6310611030/Heatstroke-Project/Documents/CNP05-paper.pdf

ระบบแจ้งเตือนฮีทสโตรก

Heatstroke warning system
นายภัทรกร แก้วชูกุล
ภาควิชาวิศวกรรมคอมพิวเตอร์ คณะวิศวกรรมศาสตร์ มหาวิทยาลัยธรรมศาสตร์

บทคัดย่อ

ฮีทสโตรกเป็นภาวะที ่เกิดขึ้นเมื ่อร ่างกายมี อุณหภูมิที่สูงเกินไปจนกระทั่งร่างกายปรับสภาพไม่ ทัน เกิดจากการอยู ่ในสภาพอากาศที ่ร้อนจัดเป็น เวลานานซึ่งอาจท าให้เสียชีวิตได้ ในปัจจุบันเรายังไม่ มีเครื ่องมือที ่ใช้ในการแจ้งเตือนการเกิดภาวะฮีทส โตรก โครงงานนี้จึงสร้างระบบเฝ้าระวังและแจ้งเตือน ฮีทสโตรก ที่ประกอบด้วยเว็บไซต์และอุปกรณ์ IoT ที่ ประกอบด้วยไมโครคอนโทรลเลอร์ เซนเซอร์วัด อุณหภูมิแบบอินฟราเรด เซนเซอร์วัดความชื้น สัมพัทธ์และอุณหภูมิโดยรอบ เซนเซอร์วัดอัตราการ เต้นของหัวใจ และล าโพง Buzzer โดยอุปกรณ์ สามารถวัดค ่าอุณหภูมิภายใน อุณหภูมิโดยรอบ ความชื้นสัมพัทธ์ และอัตราการเต้นของหัวใจ เพื่อน า ข้อมูลดังกล ่าวไปค านวณหาค ่าความเสี่ยงที่จะเป็น ฮีทสโตรก และแจ้งเตือนผู้ใช้งาน รวมถึงเก็บข้อมูลลง ไปในฐานข้อมูลบนเว็บไซต์ เพื่อให้ผู้ที่สนใจน าข้อมูล ที ่ได้ไปวิเคราะห์และใช้งานต ่อได้จากการทดลอง พบว่าอุปกรณ์สามารถวัดค่าแล้วส่งข้อมูลไปเก็บบน เว็บไซต์ได้ และสามารถส ่งเสียงเตือนผ ่านล าโพง Buzzer ได้ ในส่วนของเว็บไซต์ก็สามารถแจ้งเตือนได้ ค าส าคัญ: ฮีทสโตรก, IoT, เซนเซอร์

Abstract

Heatstroke is a condition caused by the body's temperature being too high. It occurs when the body temperature reaches 40 degrees Celsius or more and usually occurs in the summer or in areas with high relative humidity in the air. It is considered o n e o f t h e m o s t s e r i o u s m e d i c a l emergencies. It can cause harm to vital organs such as the brain, heart, lungs, kidneys, and muscles. This is because there is no notification tool which can lead to death.

This project therefore had the idea to create a heatstroke monitoring and warning system that consists of a website using Django framework and IoT device, where the device consists of a microcontroller, infrared temperature sensor, temperature and humidity sensor, Heart Rate Sensor, and B u z z e r t o k e e p t r a c k o f t h e b o d y temperature Ambient temperature relative humidity and heart rate to use all this information to calculate the risk of heatstroke and notify users then store information in a database on the website so that those who are interested can analyze and use the information.
Keyword: Heatstroke, IoT, Sensor

บทน า

ฮีทสโตรก (Heatstroke) เป็นภาวะที ่เกิด จากร ่างกายมีอุณหภูมิที ่สูงเกินไป เกิดขึ้นเมื่อ อุณหภูมิร ่างกายสูงถึง 40 องศาเซลเซียส หรือ มากกว่า และมักจะเกิดในช่วงฤดูร้อนหรือบริเวณที่มี ความชื้นสัมพัทธ์ในอากาศสูง นับเป็นหนึ่งในภาวะ ฉุกเฉินทางการแพทย์ที่ร้ายแรง และอาจท าให้เกิด อันตรายต่ออวัยวะส าคัญ เช่น สมอง หัวใจ ปอด ไต และกล้ามเนื้อได้ เนื่องจากประเทศไทยในฤดูร้อนมี อุณหภูมิสูงในหลายภูมิภาค จากข้อมูลการเฝ้าระวัง เรื ่องการเสียชีวิตจากภาวะอากาศร้อนของกอง ระบาดวิทยา กรมควบคุมโรค ระหว ่าง มีนาคม-พฤษภาคม พ.ศ. 2558 - 2564 มีข้อมูลผู้เสียชีวิต จากภาวะอากาศร้อนจ านวนทั้งสิ้น 234 ราย ที่เกิด จากการอยู ่ในสภาพอากาศที ่ร้อนจัดเป็นเวลานาน จนกระทั ่งร ่างกายปรับสภาพไม ่ทัน การเกิด ภาวะฮีทสโตรกบุคคลทั่วไปไม่สามารถรู้ล่วงหน้าได้ เลยว่าจะเกิดภาวะฮีทสโตรกเมื่อไหร่ เนื่องจากไม่มี เครื่องมือในการแจ้งเตือนซึ่งอาจท าให้เสียชีวิตได้

โครงงานนี้จึงมีความคิดที ่สร้างระบบเฝ้า ระวังและแจ้งเตือนฮีทสโตรก เพื่อติดตามอุณหภูมิ ภายใน อุณหภูมิโดยรอบ ความชื้นสัมพัทธ์ และอัตรา การเต้นของหัวใจเพื่อน าข้อมูลดังกล่าวไปค านวณหา ค ่าความเสี ่ยงที ่จะเป็นฮีทสโตรก และแจ้งเตือน ผู้ใช้งานรวมถึงเก็บข้อมูลลงไปในฐานข้อมูลบน เว็บไซต์เพื่อให้ผู้ที่สนใจน าข้อมูลที่ได้ไปวิเคราะห์และ ใช้งานต่อได้

วัตถุประสงค์
1. เพื่อออกแบบและพัฒนาระบบตรวจจับ และเฝ้าระวังฮีทสโตรกที่สามารถแจ้งเตือน ผู้ใช้งานได้
2. เพื่อเก็บข้อมูลอุณหภูมิภายในร่างกาย อุณหภูมิโดยรอบ ค่าความชื้นสัมพัทธ์ อัตราการเต้นของหัวใจ และค านวณค่า ความเสี่ยงที่จะเกิดฮีทสโตรก
3. เพื่อรวบรวมข้อมูลส าหรับผู้สนใจน าไป วิเคราะห์หรือใช้งานต่อได้

ขอบเขตของโครงงาน
1. ออกแบบและพัฒนาระบบแจ้งเตือนที่ ประกอบไปด้วย
1.1. อุปกรณ์ตรวจวัดที่วัดค่าได้ ดังนี้ อุณหภูมิร่างกาย ความชื้นสัมพัทธ์ อุณหภูมิโดยรอบ และอัตราการเต้น ข อ ง หั ว ใ จ ป ร ะ ก อ บ ด้ ว ย ไมโครคอนโทรลเลอร์, เซนเซอร์วัด อุณหภูมิพื้นผิว, เซนเซอร์วัดความชื้น

สัม พัท ธ์แ ล ะ อุณ ห ภู มิ โ ด ย ร อ บ , เซนเซอร์วัดอัตราการเต้นของหัวใจที่ ติดไว้ที่นิ้วมือ และ Buzzer
1.2. อุปกรณ์ตรวจวัดสามารถส่งข้อมูลที่ วัดได้ไปให้ฐานข้อมูล เมื่อเซนเซอร์วัด ค่าได้ค่าสูงในระดับที่เสี่ยงต่อการเกิด ฮีทสโตรกระบบจะแจ้งเตือนผู้ใช้หาก มีโอกาสเกิดฮีทสโตรกผ่านเสียงด้วย Buzzer มี 2 ระดับดังนี้
1.1.1. ค่าความเสี่ยงสูง ใช้เสียง ความถี่สูงส่งเสียงและหยุด
เป็นระยะ
1.1.2. ค่าความเสี่ยงสูงมาก ใช้เสียง ความถี่สูงส่งเสียงต่อเนื่อง
1.2. เว็บไซต์แสดงผลระดับความเสี่ยงและ กราฟของข้อมูลที่วัดได้จากอุปกรณ์ ตรวจวัด
1.3. วิเคราะห์ ค านวณค่าความเสี่ยงใน การเกิดฮีทสโตรก แบ่งเป็นระดับ 4 ระดับ
1.3.1. ความเสี่ยงระดับปกติ
1.3.2. ความเสี่ยงระดับปานกลาง
1.3.3. ความเสี่ยงระดับสูง
1.3.4. ความเสี่ยงระดับสูงมาก
2. แสดงผลผ่านเว็บไซต์ด้วย Django framework ประกอบด้วยหน้าดังนี้
2.1. หน้า Sign up สามารถให้ผู้ที่สนใจ สมัครมาเป็นผู้ใช้งานทั่วไปได้
2.2. หน้า Login สามารถเข้าสู่ระบบและ ใช้ฟังก์ชั่น Notification ได้
2.3. หน้า Home เป็นหน้าแรกของเว็บไซต์
2.4. หน้า Display data แสดงกราฟและ สถานะความเสี่ยงที่ได้รับมาจาก อุปกรณ์
2.5. หน้า Latest data แสดงผลข้อมูล ล่าสุดที่เก็บค่าได้ถ้าผู้ใช้เข้าสู่ระบบ
2.6. หน้า Risk infoแสดงข้อมูลเกี่ยวกับ การค านวณหาค่าความเสี่ยง
3. ระบบจะรองรับผู้ใช้งาน 2 ประเภทดังนี้
3.1. ผู้ใช้งานทั่วไป สามารถดูข้อมูล ดังต่อไปนี้
3.1.1. สถานะความเสี่ยง ค่าอุณหภูมิ ภายในร่างกาย ค่าอุณหภูมิ
โดยรอบ ค่าความชื้นสัมพัทธ์ ณ ขณะนั้น
3.1.2. กราฟอุณหภูมิโดยรอบ ค่า ความชื้นสัมพัทธ์ อุณหภูมิจาก ผิวหนัง และอุณหภูมิโดยรอบ
และอุณหภูมิจากผิวหนังใน
กราฟเดียวกัน
3.1.3.อุณหภูมิโดยรอบเฉลี่ย ค่า ความชื้นสัมพัทธ์เฉลี่ย

อุณหภูมิจากผิวหนังเฉลี่ย ค่า ความเสี่ยงเฉลี่ย
3.2. ผู้ดูแ ล ะ ร ะ บ บ ส า ม า ร ถ ดูข้อ มู ล ดังต่อไปนี้
3.2.1.ข้อมูลของผู้ใช้งานแต่ละคน 3.2.2.ข้อ มูล ย้อ น ห ลัง ข อ ง แ ต่ ล ะ ผู้ใช้งาน

ประโยชนท์ คี่ าดว่าจะได้รับ
1. ได้ระบบแจ้งเตือนฮีทสโตรกที่แจ้งเตือน ผู้ใช้งานผ่านอุปกรณ์ตรวจวัดและเว็บไซต์ ที่แสดงผลเป็นระดับความเสี่ยงและกราฟ ของข้อมูลที่วัดได้จากอุปกรณ์ตรวจวัด
2. ได้กราฟที่ระบุแนวโน้มของข้อมูลที่ได้จาก อุปกรณ์ตรวจวัด ท าให้สามารถวิเคราะห์ โอกาสในการเกิดภาวะฮีทสโตรกได้ง่ายขึ้น
3. ได้ข้อมูลเกี่ยวกับฮีทสโตรก เช่น อัตราการ เต้นของหัวใจ อุณหภูมิภายในร่างกาย ความชื้นสัมพัทธ์และ อุณหภูมิโดยรอบ ซึ่ง เป็ นข้อมูลพื้นฐ านให้ผู้ที่ สนใจ น าไป วิเคราะห์และใช้งานต่อได้

ผลการด าเนินโครงงาน
1. อุปกรณ์ตรวจวัด
1.1. อุปกรณ์ตรวจวัดประกอบด้วย ESP32 DHT22 MAX30102 ติดไว้ที่นิ้วมือ

Active Buzzer และ GY-906-BAA MLX90614 วัดที่รักแร้
1.2. สามารถวัดค่าต่อไปนี้ได้ อัตราการ เต้นของหัวใจ อุณหภูมิภายนอก อุณหภูมิร่าง กา ย และ คว า ม ชื้น สัมพัทธ์และค านวณค่าความเสี่ยงที่ จะเป็นฮีทสโตรก
1.3. ส า ม า ร ถ ส่ ง ข้อ มูล ที่ วัด ไ ด้ไ ป ใ ห้ ฐานข้อมูลโดยใช้ HTTP Client
1.4. สามารถแจ้งเตือนผ่านเสียงด้วย ล าโพง Buzzer มี 2 ระดับ
1.4.1. ค่าความเสี่ยงสูง ส่งเสียงยาว และหยุดไปเรื่อย ๆ จนกว่าค่า ความเสี่ยงจะลดลง
1.4.2. ค่าความเสี่ยงสูงมาก ส่งเสียง สั้นและหยุดไปเรื่อย ๆ จนกว่า ค่าความเสี่ยงจะลดลง
1.5 ตรวจสอบความถูกต้องของการอ่าน ค่าอุณหภูมิภายนอกของ DHT22 ได้ ท าการปรับค่าจนมีเปอร์เซ็นต์ความ ค ล า ด เ ค ลื่ อ น ม า ก ที่ สุ ด ที่ 2 . 5 เปอร์เซ็นต์
1.6. ตรวจสอบความถูกต้องของการอ่าน ค่าความชื้นสัมพัทธ์ของ DHT22 ได้ ท าการปรับค่าจนมีเปอร์เซ็นต์ความ ค ล า ด เ ค ลื่ อ น ม า ก ที่ สุ ด ที่ 2 . 6 5 เปอร์เซ็นต์

1.7. ตรวจสอบความถูกต้องของการอ่าน ค่าอุณหภูมิของเซนเซอร์วัดอุณหภูมิ แบบอินฟราเรด มีข้อมูลที่มีเปอร์เซ็นต์ ความคลาดเคลื่อนมากที่สุดจะอยู่ที่ 0.55 เปอร์เซ็นต์จึงไม่ได้ท าการปรับ ค่า
1.8. ตรวจสอบความถูกต้องของการอ่าน ค่ า อัต ร า ก า ร เ ต้น ข อ ง หัว ใ จ ข อ ง เซนเซอร์วัดอัตราการเต้นของหัวใจ มี เปอร์เซ็นต์ความคลาดเคลื่อนของ เซนเซอร์สูงสุดอยู่ที่ 10.71 เปอร์เซ็นต์ แต่ค่าที่คลาดเคลื่อนไม่ไปในทิศทาง เดียวกัน ท าให้เมื่อปรับค่าแล้วยังมี เปอร์เซ็นต์ความคลาดเคลื่อนที่สูงอยู่ ซึ่งไม่อาจหลีกเลี่ยงได้จึงไม่ได้ท าการ ปรับค่า
1.9. ท าการทดลองเพื่อวัดผลว่าอุณหภูมิ ภายนอกและความชื้นสัมพัทธ์ส่งผล ต่ออุณหภูมิภายในร่างกายหรือไม่ จากการทดลองท าให้เห็นว่าอุณหภูมิ ภายนอกสูงขึ้นท าให้อุณหภูมิภายใน สูงขึ้นด้วย
2. เว็บไซต์
2.1. หน้า Home
2.2. หน้า Login
2.3. หน้า Sign up
2.4. หน้า Latest data แสดงผลข้อมูลที่ บันทึกล่าสุดที่อ่านค่าได้จากอุปกรณ์ ตรวจวัดแยกแต่ละผู้ใช้งาน โดยจะ แสดงผลก็ต่อเมื่อผู้ใช้งานเข้าสู่ระบบ
2.5. หน้า Display data มีกราฟแสดงผล พ ร้อ ม ค่ า เ ฉ ลี่ ย ข อ ง ค่ า ต่ อ ไ ป นี้ อุณหภูมิโดยรอบ ค่าความชื้นสัมพัทธ์ อุณหภูมิภายในร่างกาย ค่าความ เสี่ยงที่จะเป็ นฮีทสโตรก อุณหภูมิ โดยรอบและอุณหภูมิภายในร่างกาย ในกราฟเดียวกัน และกราฟของค่า ทั้งหมดในกราฟเดียวกัน โดยแยกแต่ ละผู้ใช้งาน โดยที่กราฟแสดงค่าความ เสี่ยงที่จะเป็นฮีทสโตรกจะแบ่งแถบสี ตามความเสี่ยง
2.6. การแจ้งเตือนบนเว็บไซต์เมื่อข้อมูลที่ ได้รับจากอุปกรณ์ตรวจวัดมีค่าความ เสี่ยงที่จะเป็นฮีทสโตรกสูงหรือสูงมาก เว็บไซต์จะท าการแจ้งเตือน โดยจะมี การแจ้งเตือน 2 แบบด้วยกันคือแบบ JavaScript alert และแบบ local notification

สรุปและข้อเสนอแนะ
1. สรุปผลโครงงาน
โครงงานนี้ได้พัฒนาระบบแจ้งเตือน ฮีทสโตรกที่วัดค่าจากอุปกรณ์ตรวจวัดที่

ประกอบไปด้วย Esp32 DHT22 Max30102 A c t i v e b u z z e r แ ล ะ GY -906- B A A MLX90614 แล้วน าค่าที่วัดได้ ไปค านวณ เป็นค่าความเสี่ยงที่จะเป็นฮีทสโตรก และแจ้ง เตือน ผ่าน buzzer เมื่อมีค่าความเสี่ยงที่จะ เป็นheat Stroke สูง จากนั้นน าข้อมูลที่ได้ไป บันทึกลงฐานข้อมูลและแสดงบนเว็บไซต์ พร้อมแจ้งเตือนเมื่อมีค่าความเสี่ยงที่จะเป็น ฮีทสโตรกสูง โดยที่เว็บไซต์แสดงข้อมูลเป็น กราฟของอุณหภูมิภายในร่างกาย อุณหภูมิ ภายนอก ความชื้นสัมพัทธ์ ค่าความเสี่ยงที่ เป็นฮีทสโตรก และอัตราการเต้นของหัวใจ
2. ข้อเสนอแนะ
2.1. พัฒนาเป็นเว็บแอปพลิเคชันเพื่อเข้าถึง ผู้ใช้งานได้ง่ายและสะดวกขึ้น
2.2. ขอความเห็นจากแพทย์เพื่อให้สามารถ พัฒนาระบบแจ้งเตือนได้แม่นย ามากขึ้น

บรรณานุกรม
[1] D. Ruthirago and P. Laengvejkal, “Be careful of heatstroke – a potentially life-
threatening form of heat illness | Bangkok
International Hospital,”
www.bangkokinternationalhospital.com. https://www.bangkokinternationalhospital.com/health-articles/disease-treatment/hot-weather-must-be-careful-of-heatstroke (accessed Nov. 13, 2023).
[2] Mouser Electronics, “MLX90614 family,” Mouser Electronics.
https://th.mouser.com/ProductDetail/Melexis/MLX90614ESF-BAA-000-
TU?qs=KuGPmAKtFKVScNDmoJmFVw%3D %3D&_gl=1*41x8p3*_ga*MTg2NTM4MTQ3Ni 4xNzE2MjI2Mzk4*_ga_15W4STQT4T*MTcxNjI yNjM5Ny4xLjAuMTcxNjIyNjQwMi41NS4wLjA.
[3] Texas Instruments, “LM35 data sheet,
product information and support | TI.com,”
Ti.com, 2017.
https://www.ti.com/product/LM35
[4] Bosch Sensortec GmbH, “BME280 sensor API,” GitHub, Nov. 03, 2023. https://github.com/BoschSensortec/BME280_driver (accessed Nov. 20, 2023).
[5] Adafruit Industries, “DHT22 temperature-humidity sensor + extras,” Adafruit.com, 2019. https://www.adafruit.com/product/385
[6] Sensirion AG, “SHT35-DIS-F,” sensirion.com.
https://sensirion.com/products/catalog/SHT35 -DIS-F (accessed Nov. 20, 2023).

[7] Texas Instruments Incorporated, “HDC1080 data sheet, product information
and support | TI.com,” www.ti.com.
https://www.ti.com/product/HDC1080 (accessed Nov. 20, 2023).
[8] Espressif, “ESP32 Series Datasheet .” Available:
https://www.espressif.com/sites/default/files/documentation/esp32_datasheet_en.pdf
[9] World Famous Electronics LLC, “WorldFamousElectronics/PulseSensorPlaygr ound,” GitHub, May 19, 2023. https://github.com/WorldFamousElectronics/P ulseSensorPlayground
[10] Analog Devices, “MAX30102 High-Sensitivity Pulse Oximeter and Heart-Rate
Sensor for Wearable Health | Analog
Devices,” Analog.com, 2018. https://www.analog.com/en/products/max301 02.html
[11] Django, “Django,” Django Project. https://docs.djangoproject.com/en/4.2/
[12] S.-T. Chen, S.-S. Lin, C.-W. Lan, and H.-
Y. Hsu, “Design and Development of a Wearable Device for Heat Stroke Detection,”

Sensors, vol. 18, no. 2, p. 17, Dec. 2017, doi: https://doi.org/10.3390/s18010017.
[13] T. W. Son, D. A. Ramli, and A. A. Aziz, “Wearable Heat Stroke Detection System in IoT-based Environment,” Procedia Computer Science, vol. 192, pp. 3686–3695, 2021, doi: https://doi.org/10.1016/j.procs.2021.09.142.
[14] M. I. R. and D. THAI METEOROLOGICAL DEPARTMENT, “Heat Index R&D TMD,” www.rnd.tmd.go.th.
http://www.rnd.tmd.go.th/heatindexanalysis/ .
[15] S.-S. Lin, C.-W. Lan, H.-Y. Hsu, and S.-T. Chen, “Data Analytics of a Wearable Device for Heat Stroke Detection,” Sensors, vol. 18, no. 12, p. 4347, Dec. 2018, doi: https://doi.org/10.3390/s18124347.
[16] SYNPHAET HOSPITAL, “โรคฮีทสโตรก (Heat Stroke) หรือโรคลมแดด - โรงพยาบาลสิน แพทย์,” โรงพยาบาลสินแพทย์, Mar. 28, 2023. https://www.synphaet.co.th/%E0%B9%82%E 0%B8%A3%E0%B8%84%E0%B8%AE%E0% B8%B5%E0%B8%97%E0%B8%AA%E0%B9 %82%E0%B8%95%E0%B8%A3%E0%B8%8 1-heat-stroke-
%E0%B8%AB%E0%B8%A3%E0%B8%B7%E

0%B8%AD%E0%B9%82%E0%B8%A3%E0% B8%84%E0%B8%A5%E0%B8%A1/
[17] ส านักงานป้องกันควบคุมโรคที่ 7ขอนแก่น, “แพทย์เตือน ภาวะเจ็บป่ วยจากลมร้อน ‘ฮีทสโตรก’ เสี่ยงอาการรุนแรง และอาจเสียชีวิตได้,” ddc.moph.go.th, Mar. 25, 2022. https://ddc.moph.go.th/odpc7/news.php?news=24196&deptcode=odpc7&news_views=42 72
[18] Centers for Disease Control and Prevention, “Frequently Asked Questions
(FAQ) About Extreme Heat | Natural Disasters
and Severe Weather | CDC,” www.cdc.gov,
Apr. 14, 2020.
https://www.cdc.gov/disasters/extremeheat/faq.html#:~:text=Heat%20stroke%20is%20the %20most
[19] T. Durongbhandhu, “โรคลมร้อน (Heat Stroke) ,” Thailand Digital Journal, Oct. 2019. https://thaidj.org/index.php/CHJ/article/download/7412/7641/11666
[20] Adafruit, “adafruit/DHT-sensor-library,” GitHub, May 04, 2020.
https://github.com/adafruit/DHT-sensor-library
[21] โรงพยาบาลศิครินทร์, “วิธีเช็ดตัว ‘ลดไข้’ ที่ ถูกต้อง ควรท าอย่างไร ? - โรงพยาบาลศิครินทร์,” โรงพยาบาลศิครินทร์, Aug. 19, 2021. https://www.sikarin.com/health/%e0%b8%a7 %e0%b8%b4%e0%b8%98%e0%b8%b5%e0 %b9%80%e0%b8%8a%e0%b9%87%e0%b8 %94%e0%b8%95%e0%b8%b1%e0%b8%a7-%e0%b8%a5%e0%b8%94%e0%b9%84%e0 %b8%82%e0%b9%89-
%e0%b8%97%e0%b8%b5%e0%b9%88%e0 %b8%96%e0%b8%b9 (accessed Feb. 5, 2024).
