6310611030/Heatstroke-Project/Documents/CNP05-progress2.pdf

### รายงานความคืบหน้าโครงงาน 2

ชื่อโครงงานภาษาไทย: ระบบแจ้งเตือนฮีทสโตรก

ชื่อโครงงานภาษาอังกฤษ: Heatstroke warning system

ชื่อและเลขทะเบียนนักศึกษา: ภัทรกร แก้วชูกุล 6310611030

อาจารย์ที่ปรึกษา: อ.ดร.กาญจนา ศิลาวราเวทย์

### 1. เค้าโครงของโครงงาน 1.1. ที่มาและความส าคัญ

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

### 1.2. วัตถุประสงค์

### 1.2.1. เพื่อออกแบบและพัฒนาระบบตรวจจับและเฝ้าระวังฮีทสโตรกที่สามารถแจ้งเตือนผู้ใช้งานได้

1.2.2. เพื่อเก็บข้อมูลอุณหภูมิภายในร่างกาย อุณหภูมิโดยรอบ ค่าความชื้นสัมพัทธ์อัตราการเต้นของ หัวใจ และค านวณค่าความเสี่ยงที่จะเกิดฮีทสโตรก

### 1.2.3. เพื่อรวบรวมข้อมูลส าหรับผู้สนใจน าไปวิเคราะห์หรือใช้งานต่อได้

### 1.3. ขอบเขต

### 1.3.1 ออกแบบและพัฒนาระบบแจ้งเตือนที่ประกอบไปด้วย

- อุปกรณ์ตรวจวัดที่วัดค่าได้ ดังนี้ อุณหภูมิร่างกาย ความชื้นสัมพัทธ์อุณหภูมิโดยรอบ และ อัตราการเต้นของหัวใจ ประกอบด้วยไมโครคอนโทรลเลอร์, เซนเซอร์วัดอุณหภูมิพื้นผิว, เซนเซอร์วัดความชื้นสัมพัทธ์และอุณหภูมิโดยรอบ, เซนเซอร์วัดอัตราการเต้นของหัวใจที่ติดไว้ที่ นิ้วมือ และ Buzzer
- อุปกรณ์ตรวจวัดสามารถส่งข้อมูลที่วัดได้ไปให้ฐานข้อมูล เมื่อเซนเซอร์วัดค่าได้ค่าสูงในระดับที่ เสี ่ยงต ่อการเกิดฮีทสโตรกระบบจะแจ้งเตือนผู้ใช้หากมีโอกาสเกิดฮีทสโตรกผ่านเสียงด้วย Buzzer มี 2 ระดับดังนี้
- ค่าความเสี่ยงสูง ใช้เสียงความถี่สูงส่งเสียงและหยุดเป็นระยะ
- ค่าความเสี่ยงสูงมาก ใช้เสียงความถี่สูงส่งเสียงต่อเนื่อง
- เว็บไซต์แสดงผลระดับความเสี่ยงและกราฟของข้อมูลที่วัดได้จากอุปกรณ์ตรวจวัด
- วิเคราะห์ ค านวณค่าความเสี่ยงในการเกิดฮีทสโตรก แบ่งเป็นระดับ 4 ระดับ
- ความเสี่ยงระดับปกติ
- ความเสี่ยงระดับปานกลาง
- ความเสี่ยงระดับสูง
- ความเสี่ยงระดับสูงมาก

### 1.3.2 แสดงผลผ่านเว็บไซต์ด้วย Django framework ประกอบด้วยหน้าดังนี้

- หน้า Sign up สามารถให้ผู้ที่สนใจสมัครมาเป็นผู้ใช้งานทั่วไปได้
- หน้า Login สามารถเข้าสู่ระบบและใช้ฟังก์ชั่น Notification ได้
- หน้า Home เป็นหน้าแรกของเว็บไซต์
- หน้า Display data แสดงกราฟและสถานะความเสี่ยงที่ได้รับมาจากอุปกรณ์
- หน้า Latest data แสดงผลข้อมูลล่าสุดที่เก็บค่าได้ถ้าผู้ใช้เข้าสู่ระบบ

### 1.3.3 ระบบจะรองรับผู้ใช้งาน 2 ประเภทดังนี้

- ผู้ใช้งานทั่วไป สามารถดูข้อมูลดังต่อไปนี้
- สถานะความเสี่ยง
- ค่าอุณหภูมิภายในร่างกาย ค่าอุณหภูมิโดยรอบ ค่าความชื้นสัมพัทธ์ณ ขณะนั้น
- กราฟอุณหภูมิโดยรอบ ค่าความชื้นสัมพัทธ์อุณหภูมิจากผิวหนัง อุณหภูมิโดยรอบ เฉลี่ย ค่าความชื้นสัมพัทธ์เฉลี่ย อุณหภูมิจากผิวหนังเฉลี่ย และอุณหภูมิโดยรอบและ อุณหภูมิจากผิวหนังในกราฟเดียวกัน

- ผู้ดูและระบบ สามารถดูข้อมูลดังต่อไปนี้
- เลือกข้อมูลของผู้ใช้งานแต่ละคน
- กราฟแสดงผลภาพรวมรายวันจากทุกผู้ใช้งานโดยรวม กราฟอุณหภูมิโดยรอบ ค่าความชื้น สัมพัทธ์อุณหภูมิจากผิวหนัง อุณหภูมิโดยรอบเฉลี่ย ค่าความชื้นสัมพัทธ์เฉลี่ย อุณหภูมิ จากผิวหนังเฉลี่ย และอุณหภูมิโดยรอบและอุณหภูมิจากผิวหนังในกราฟเดียวกัน
- สถานะความเสี่ยงย้อนหลังของแต่ละผู้ใช้งาน

### 1.4. ประโยชน์ที่คาดว่าจะได้รับ

1.4.1 ได้ระบบแจ้งเตือนฮีทสโตรกที่แจ้งเตือนผู้ใช้งานผ่านอุปกรณ์ตรวจวัดและเว็บไซต์ที่แสดงผลเป็น ระดับความเสี่ยงและกราฟของข้อมูลที่วัดได้จากอุปกรณ์ตรวจวัด
1.4.2 ได้ข้อมูลเกี่ยวกับฮีทสโตรกที่เป็นข้อมูลพื้นฐานให้ผู้ที่สนใจน าไปวิเคราะห์และใช้งานต่อได้

### 2. สรุปผลการด าเนินการโครงงาน 1 2.1. อุปกรณ์ตรวจวัด 2.1.1. วัดค่าอุณหภูมิโดยรอบ อุณหภูมิจากผิวหนังและค่าความชื้นสัมพัทธ์ 2.1.2. ส่งข้อมูลที่วัดได้ไปยังฐานข้อมูล 2.1.3. ส่งเสียงแจ้งเตือนเมื่ออุปกรณ์วัดค่าได้ถึงค่าที่ก าหนด

### 2.2. เว็บไซต์ 2.2.1. รับข้อมูลจากอุปกรณ์มาเก็บเข้าฐานข้อมูล 2.2.2. สร้างผู้ใช้งานใหม่ในระบบ 2.2.3. เข้าสู่ระบบ

### 2.2.4. ออกจากระบบ 3. ผลการด าเนินการโครงงาน 2 3.1. การทดลอง

3.1.1.ตรวจสอบความถูกต้องของการอ่านค่าอุณหภูมิของ DHT22 โดยการเปรียบเทียบอุณหภูมิกับเทอร์โมมิเตอร์แบบปรอท (เนื่องจากเทอร์โมมิเตอร์ที่น ามาใช้ในการ วัดไม่สามารถวัดจุดทศนิยมได้จึงอาจท าให้เกิดการคลาดเคลื่อน) เริ่มการตั้งค่าโดยน า DHT22 และ เทอร์โมมิเตอร์มาไว้ที่จุดเดียวกัน รอจนอุณหภูมิคงที่และท าการวัดค่าที่ได้ ท าการวัดทุกๆ ครึ่งชั่วโมง เป็นเวลา 6 ชั่วโมง ถ้าค่าที่ได้จากเซนเซอร์DHT22 มีความคลาดเคลื่อนมากกว่า 5 เปอร์เซ็นต์จึงจะ ท าการปรับให้ใกล้เคียง

ตารางที่ 1 แสดงค่าอุณหภูมิที่ที่วัดได้จากเทอร์โมมิเตอร์และเซนเซอร์ พร้อมทั้งเปอร์เซ็นต์ความคลาดเคลื่อนของเซนเซอร์
ล ำดับที่ | อุณหภูมิจำก เทอร์โมมิเตอร์ (°C) | อุณหภูมิจำกเซนเซอร์ (°C) | เปอร์เซ็นต์ควำมคลำด เคลื่อน (%)
1 | 26 | 25.1 | 3.46
2 | 24 | 24.4 | 1.67
3 | 25 | 24.4 | 2.40
4 | 24 | 25.2 | 5.00
5 | 25 | 24.8 | 0.80
6 | 25 | 25.0 | 0
7 | 29 | 29.0 | 0
8 | 30 | 30.5 | 1.67
9 | 31 | 30.9 | 0.32
10 | 26 | 25.6 | 1.54
11 | 25 | 24.2 | 3.20
12 | 24 | 23.7 | 1.25
จากตารางที่ 1 เริ่มการตรวจสอบโดยวัดอุณหภูมิขณะที่อยู่ในห้องแอร์ข้อมูลล าดับที่ 1 – 6 และ 10 – 12 เป็นการวัดขณะเปิดแอร์ และข้อมูลล าดับที่ 7 – 9 เป็นการวัดขณะปิดแอร์ค ่าความ คลาดเคลื่อนมีความไม่แน่นอนเนื่องจากเทอร์โมมิเตอร์ที่ใช้เป็นแบบ analog ไม่มีจุดทศนิยม จากการ

Fig.1: กราฟเปรียบเทียบค่าอุณหภูมิที่ที่วัดได้จากเทอร์โมมิเตอร์และเซนเซอร์

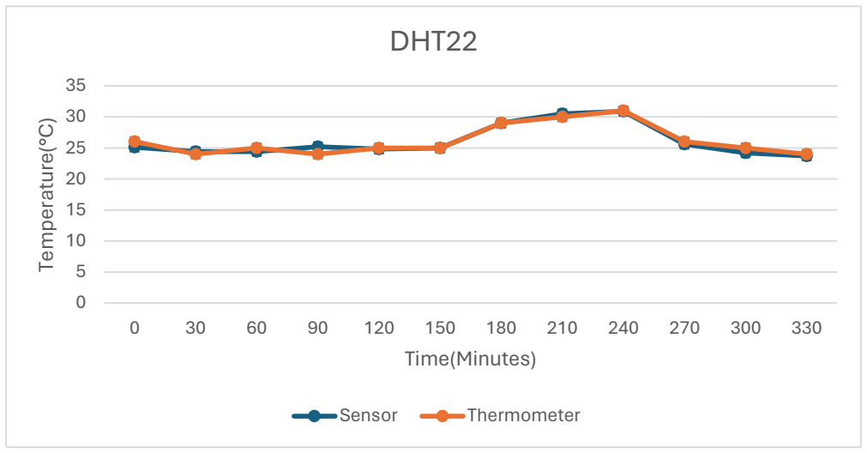
[picture p3: figure]
Temperature(°C); Time(Minutes); DHT22; Sensor; Thermometer

จากกราฟจะเห็นได้ว่าค่าของเซนเซอร์และเทอร์โมมิเตอร์มีความใกล้เคียงและมีแนวโน้มไปในทิศทาง เดียวกัน จากการวัดพบว่าเกิดความคลาดเคลื่อนมากกว่า 5 เปอร์เซ็นต์จึงท าการตั่งค่าชดเชยเพื่อให้ ได้ค่าที่ใกล้เคียงค่าที่ถูกต้องและมีความคลาดเคลื่อนไม่เกิน 5 เปอร์เซ็นต์

### 3.1.2. ตรวจสอบความถูกต้องของการอ่านค่าอุณหภูมิของเซนเซอร์วัดอุณหภูมิแบบอินฟราเรด

โดยการเปรียบเทียบอุณหภูมิที่วัดได้กับเทอร์โมมิเตอร์วัดไข้ เริ่มการตั้งค่าโดยการน าเทอร์โมมิเตอร์วัด ไข้มาเสียบไว้ที่รักแร้และน าเซนเซอร์มาวัดที่ข้อมือโดยมีระยะห่าง 4 เซนติเมตร รอจนเทอร์โมมิเตอร์ วัดไข้วัดแล้วอุณหภูมิไม่เปลี่ยนแปลงแล้วน าค่าที่ได้มาเปรียบเทียบกับค่าที่วัดได้จากเซนเซอร์ในเวลา เดียวกัน ท าการวัดทุกๆ ครึ่งชั่วโมงเป็นเวลา 6 ชั่วโมง 3.1.3.ตรวจสอบความถูกต้องของการอ่านค่าอัตราการเต้นของหัวใจของเซนเซอร์วัดอัตราการ เต้นของหัวใจ
โดยการเปรียบเทียบกับเครื่องวัดความดัน(Omron)และนาฬิกาสุขภาพ(Garmin) เริ่มการตั้งค่าโดย น าปลอกแขนของเครื่องวัดความดันใส่ไว้ที่แขนข้างใดข้างหนึ่งและน านาฬิกากับเซนเซอร์มาใส่ไว้ที่ แขนข้างเดียวกัน(เซนเซอร์สวมไว้ที่นิ้วโป้งรัดด้วยหนังยางหรือตีนตุ๊กแก) จากนั้นท าการวัดค่าด้วย เครื่องวัดความดัน เมื่อวัดเสร็จน าค่าที่ได้ไปเปรียบเทียบกับค่าที่วัดได้ของเซนเซอร์และนาฬิกาในเวลา เดียวกัน ท าการวัดทุกๆ ครึ่งชั่วโมงเป็นเวลา 6 ชั่วโมง

### 3.1.4. ท าการทดลองเพื่อวัดผลว่าอุณหภูมิภายนอกและความชื้นสัมพัทธ์ส่งผลต่ออุณหภูมิ

ภายในร่างกายหรือไม่
โดยใช้เซนเซอร์ DHT 22 และเซนเซอร์วัดอุณหภูมิแบบอินฟราเรด เริ่มการทดลองโดยการนั่งรอจน อุณหภูมิร่างกายคงที่ จากนั้นจึงท าการวัดค่าและบันทึกผลทุกๆ 30 วินาที

### 3.2. เว็บไซต์

3.2.1.หน้า Home
มีการเพิ่มลิงค์เพื่อเข้าสู่หน้า Latest data และ Display data

### 3.2.2. หน้า Latest data

มีการแสดงผลข้อมูลที่บันทึกล่าสุดที่อ่านค่าได้จากเซนเซอร์แยกแต่ละผู้ใช้งาน โดยจะแสดงผลก็ต่อเมื่อ ผู้ใช้งานเข้าสู่ระบบ

### 3.2.3. หน้า Display data

มีกราฟแสดงผลของค่าต่อไปนี้ อุณหภูมิโดยรอบ ค่าความชื้นสัมพัทธ์อุณหภูมิจากผิวหนัง อุณหภูมิ โดยรอบเฉลี่ย ค่าความชื้นสัมพัทธ์เฉลี่ย อุณหภูมิจากผิวหนังเฉลี่ย และอุณหภูมิโดยรอบและอุณหภูมิ จากผิวหนังในกราฟเดียวกัน โดยแยกแต่ละผู้ใช้งาน

### 4. ปัญหาและอุปสรรค

4.1. เซนเซอร์แบบอินฟราเรดมีความคลาดเคลื่อนเนื่องจากมีระยะในการวัด 4 ซม. ท าให้มีโอกาสที่จะมีแสงเข้า มารบกวน
4.2. การใช้งานเซนเซอร์อัตราการเต้นของหัวใจ XD-58C Pulse Sensor ยังมีปัญหาเรื่องการค านวณค่าอัตรา การเต้นของหัวใจ เนื่องจากมีเอกสารที่เกี่ยวข้องน้อยท าให้ต้องใช้เวลาในการศึกษาเพิ่มเติม

### 4.3. External Network adapter ไม่เสถียรท าให้บางครั้งไม่สามารถส่งข้อมูลไปยังเว็บไซต์ได้

### 5. แผนด าเนินงานต่อไป

5.1. ค านวณค่าที่ได้จากเซนเซอร์แล้วเปลี่ยนเป็นค่าความเสี่ยงแล้วส่งไปบันทึกที่ฐานข้อมูล 5.2. แสดงผลค่าความเสี่ยงบนเว็บไซต์ 5.3. ท าปุ่มแจ้งเตือนบนเว็บไซต์เมื่อมีค่าความเสี่ยงสูงจะมีการแจ้งเตือนบนเว็บไซต์ 5.4. เขียนโปรแกรมในการค านวณค่าอัตราการเต้นของหัวใจ 5.5. ปรับแต่งอุปกรณ์เพื่อให้สามารถน าอุปกรณ์ไปสวมใส่ได้
5.6. ท าการทดสอบความถูกต้องของเซนเซอร์วัดอุณหภูมิแบบอินฟราเรด และเซนเซอร์วัดอัตราการเต้นของ หัวใจ
5.7. ท าการทดลองเพื่อวัดผลว่าอุณหภูมิภายนอกและความชื้นสัมพัทธ์ส่งผลต่ออุณหภูมิภายในร่างกายหรือไม่

### 5.8. ทดสอบการใช้งานเว็บไซต์

### 6. คาดการณ์ผลงานขั้นสุดท้าย

6.1. ได้อุปกรณ์ที่สามารถแจ้งเตือนความเสี ่ยงในการเกิดฮีทสโตรก โดยประเมินจากข้อมูลอุณหภูมิร่างกาย ความชื้นสัมพัทธ์อุณหภูมิโดยรอบ และอัตราการเต้นของหัวใจ
6.2. เว็บไซต์สามารถรับข้อมูลจากอุปกรณ์ เรียกดูข้อมูลล่าสุดและข้อมูลที่บันทึกไว้ในรูปแบบกราฟ

### 7. บรรณานุกรม

[1] A. Bouchama and J. P. Knochel, “Heat Stroke,” New England Journal of Medicine, vol. 346, no. 25, pp. 1978–1988, Jun. 2002, doi: https://doi.org/10.1056/nejmra011089.
[2] J. G. Labs Principal Application Engineer, Sensor Products, Silicon, “High-Precision Temperature Sensing for Core Temperature Monitoring in Wearable Electronics,” Electrical Engineering News and Products, Nov. 23, 2016. https://www.eeworldonline.com/high-precision-temperature-sensing-for-coretemperature-monitoring-in-wearable-electronics/
[3] Melexis, “MLX90614 family.”
[4] Texas Instruments Incorporated, “LM35.”
[5] Bosch Sensortec GmbH, “BME280 sensor API,” GitHub, Nov. 03, 2023. https://github.com/BoschSensortec/BME280_driver (accessed Nov. 20, 2023).
[6] A. Industries, “DHT11 basic temperature-humidity sensor + extras,” www.adafruit.com. https://www.adafruit.com/product/386

[7] Adafruit Industries, “DHT22 temperature-humidity sensor + extras,” Adafruit.com, 2019. https://www.adafruit.com/product/385
[8] Sensirion AG, “SHT31-DIS-B,” sensirion.com. https://sensirion.com/products/catalog/SHT31-DIS-B/
[9] Sensirion AG, “SHT35-DIS-F,” sensirion.com. https://sensirion.com/products/catalog/SHT35-DIS-F (accessed Nov. 20, 2023).
[10] Texas Instruments Incorporated, “HDC1080 data sheet, product information and
support | TI.com,” www.ti.com. https://www.ti.com/product/HDC1080 (accessed Nov.
20, 2023).
[11] Espressif, “ESP32 Series Datasheet .” Available: https://www.espressif.com/sites/default/files/documentation/esp32_datasheet_en.pdf
[12] World Famous Electronics LLC, “WorldFamousElectronics/PulseSensorPlayground,” GitHub, May 19, 2023. https://github.com/WorldFamousElectronics/PulseSensorPlayground
[13] Django, “Django,” Django Project. https://docs.djangoproject.com/en/4.2/
[14] S.-T. Chen, S.-S. Lin, C.-W. Lan, and H.-Y. Hsu, “Design and Development of a Wearable Device for Heat Stroke Detection,” Sensors, vol. 18, no. 2, p. 17, Dec. 2017, doi: https://doi.org/10.3390/s18010017.
[15] D. Ruthirago and P. Laengvejkal, “Be careful of heatstroke – a potentially life-
threatening form of heat illness | Bangkok International Hospital,”
www.bangkokinternationalhospital.com. https://www.bangkokinternationalhospital.com/health-articles/disease-treatment/hotweather-must-be-careful-of-heatstroke (accessed Nov. 13, 2023).
[16] T. W. Son, D. A. Ramli, and A. A. Aziz, “Wearable Heat Stroke Detection System in IoT-based Environment,” Procedia Computer Science, vol. 192, pp. 3686–3695, 2021, doi: https://doi.org/10.1016/j.procs.2021.09.142.
[17] C. Tamantini, Cristiana Rondoni, F. Cordella, E. Guglielmelli, and L. Zollo, “A Classification Method for Workers’ Physical Risk,” Sensors, vol. 23, no. 3, pp. 1575– 1575, Feb. 2023, doi: https://doi.org/10.3390/s23031575.
[18] R. Eichner, “Heat Stroke in Sports: Causes, Prevention and Treatment,” Gatorade Sports Science Institute, 2018. https://www.gssiweb.org/sports-scienceexchange/article/sse-86-heat-stroke-in-sports-causes-prevention-and-treatment
[19] S.-S. Lin, C.-W. Lan, H.-Y. Hsu, and S.-T. Chen, “Data Analytics of a Wearable Device for Heat Stroke Detection,” Sensors, vol. 18, no. 12, p. 4347, Dec. 2018, doi: https://doi.org/10.3390/s18124347.

[20] SYNPHAET HOSPITAL, “โรคฮีทสโตรก (Heat Stroke) หรือโรคลมแดด - โรงพยำบำลสินแพทย์,” โรงพยำบำลสินแพทย์, Mar. 28, 2023.

https://www.synphaet.co.th/%E0%B9%82%E0%B8%A3%E0%B8%84%E0%B8%AE%E0%B8%B5%E0%B8%97%E0%B8%AA%E0%B9%82%E0%B8%95%E0%B8%A3%E 0%B8%81-heat-stroke-
%E0%B8%AB%E0%B8%A3%E0%B8%B7%E0%B8%AD%E0%B9%82%E0%B8%A3 %E0%B8%84%E0%B8%A5%E0%B8%A1/
[21] ส ำนักงำนป้องกันควบคุมโรคที่ 7 ขอนแก่น, “แพทย์เตือน ภำวะเจ็บป่วยจำกลมร้อน ‘ฮีทสโตรก’ เสี่ยงอำกำรรุนแรง และอำจ
เสียชีวิตได้,” ddc.moph.go.th, Mar. 25, 2022.

https://ddc.moph.go.th/odpc7/news.php?news=24196&deptcode=odpc7&news_views=42 72

[22] Centers for Disease Control and Prevention, “Frequently Asked Questions (FAQ)
About Extreme Heat | Natural Disasters and Severe Weather | CDC,” www.cdc.gov, Apr.
14, 2020.
https://www.cdc.gov/disasters/extremeheat/faq.html#:~:text=Heat%20stroke%20is%20th e%20most
[23] T. Durongbhandhu, “โรคลมร้อน (Heat Stroke) ธรำธร ดุรงค์พันธุ์พ.บ.,” Dec. 2019.
[24] Adafruit, “adafruit/DHT-sensor-library,” GitHub, May 04, 2020. https://github.com/adafruit/DHT-sensor-library
[25] Primus, “RTD/PT100/PTC/NTC มีหลักกำรท ำงำนอย่ำงไร?,” www.primusthai.com.

https://www.primusthai.com/primus/Knowledge/info?ID=201 (accessed Nov. 20, 2023).

[26] โรงพยำบำลศิครินทร์, “วิธีเช็ดตัว ‘ลดไข้’ ที่ถูกต้อง ควรท ำอย่ำงไร ? - โรงพยำบำลศิครินทร์,” โรงพยาบาลศิครินทร์, Aug.

19, 2021.
https://www.sikarin.com/health/%e0%b8%a7%e0%b8%b4%e0%b8%98%e0%b8%b5%e 0%b9%80%e0%b8%8a%e0%b9%87%e0%b8%94%e0%b8%95%e0%b8%b1%e0%b8% a7-%e0%b8%a5%e0%b8%94%e0%b9%84%e0%b8%82%e0%b9%89-%e0%b8%97%e0%b8%b5%e0%b9%88%e0%b8%96%e0%b8%b9 (accessed Feb. 5, 2024).
