6310611030/Heatstroke-Project/Documents/CNP05-completeReport.pdf

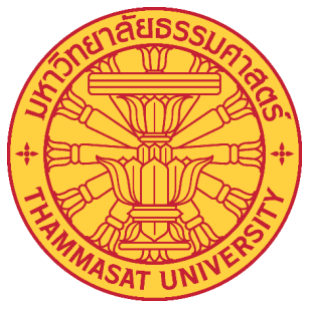
[picture p4: figure]

### ระบบแจ้งเตือนฮีทสโตรก Heatstroke warning system

### โดย

### นายภัทรกร แก้วชูกุล 6310611030

### โครงงานนีเ้ป็ นส่วนหนึ่งของการศึกษาตามหลักสูตร

### วิศวกรรมศาสตรบัณฑิต สาขาวิศวกรรมคอมพิวเตอร์ภาควิชาวิศวกรรมไฟฟ้าและคอมพิวเตอร์ คณะวิศวกรรมศาสตร์มหาวิทยาลัยธรรมศาสตร์ ปี การศึกษา 2566 ลิขสิทธิ์ของมหาวิทยาลัยธรรมศาสตร

์

### ระบบแจ้งเตือนฮีทสโตรก Heatstroke warning system

### โดย

### นายภัทรกร แก้วชูกุล 6310611030

### โครงงานนีเ้ป็ นส่วนหนึ่งของการศึกษาตามหลักสูตร

### วิศวกรรมศาสตรบัณฑิต สาขาวิศวกรรมคอมพิวเตอร์ภาควิชาวิศวกรรมไฟฟ้าและคอมพิวเตอร์ คณะวิศวกรรมศาสตร์มหาวิทยาลัยธรรมศาสตร์ ปี การศึกษา 2566 ลิขสิทธิ์ของมหาวิทยาลัยธรรมศาสตร

์

### Heatstroke warning system

By

### Phattarakorn Kaewchukul

### A PROJECT SUBMITTED IN PARTIAL FULFILLMENT OF THE REQUIREMENT FOR THE DEGREE OF BACHELOR OF ENGINEERING IN ELECTRICAL ENGINEERING / COMPUTER ENGINEERING FACULTY OF ENGINEERING THAMMASAT UNIVERSITY ACADEMIC YEAR 2023 COPYRIGHT OF THAMMASAT UNIVERSIT

หัวข้อวิทยานิพนธ์ | ระบบแจ้งเตือนฮีทสโตรก
| Heatstroke warning system
ชื่อผู้เขียน | นาย ภัทรกร แก้วชูกุล
ชื่อปริญญา | วิศวกรรมศาสตรบัณฑิต
สาขาวิชา/คณะ/มหาวิทยาลัย | สาขาวิศวกรรมคอมพิวเตอร์
| ภาควิชาวิศวกรรมไฟฟ้าและคอมพิวเตอร์
| คณะวิศวกรรมศาสตร์
| มหาวิทยาลัยธรรมศาสตร์

ภาควิชาวิศวกรรมไฟฟ้าและคอมพิวเตอร์ คณะวิศวกรรมศาสตร์ มหาวิทยาลัยธรรมศาสตร์ อนุมัติให้โครงงานนี้เป็นส่วนหนึ่งของการศึกษาตามหลักสูตรวิศวกรรมศาสตรบัณฑิต

| อาจารย์ที่ปรึกษาโครงงาน
| (อาจารย์ ดร.กาญจนา ศิลาวราเวทย์)
| | หัวหน้าภาควิชาวิศวกรรมไฟฟ้าและ

(ผู้ช่วยศาสตราจารย์ ดร.พิศาล แก้วประภา)

| คอมพิวเตอร์

ก

บทคัดย่อ
ฮีทสโตรกเป็นภาวะที่เกิดขึ้นเมื่อร่างกายมีอุณหภูมิที่สูงเกินไปจนกระทั่งร่างกายปรับสภาพไม่ทัน เกิด จากการอยู่ในสภาพอากาศที่ร้อนจัดเป็นเวลานานซึ่งอาจท าให้เสียชีวิตได้ ในปัจจุบันยังไม่มีเครื่องมือที่ใช้ ในการแจ้งเตือนการเกิดภาวะฮีทสโตรก โครงงานนี้จึงสร้างระบบเฝ้าระวังและแจ้งเตือนฮีทสโตรก ที่ ประกอบด้วยเว็บไซต์ที่ใช้ Django Framework และอุปกรณ์ IoT โดยที่อุปกรณ์ประกอบด้วย ไมโครคอนโทรลเลอร์เซนเซอร์วัดอุณหภูมิแบบอินฟราเรด เซนเซอร์วัดความชื้นสัมพัทธ์และอุณหภูมิ โดยรอบ เซนเซอร์วัดอัตราการเต้นของหัวใจ และล าโพง Buzzer โดยอุปกรณ์สามารถวัดค่าอุณหภูมิภายใน อุณหภูมิโดยรอบ ความชื้นสัมพัทธ์ และอัตราการเต้นของหัวใจ เพื่อน าข้อมูลดังกล่าวไปค านวณหาค่า ความเสี่ยงที่จะเป็นฮีทสโตรก และแจ้งเตือนผู้ใช้งานผ่านล าโพง Buzzer และเว็บไซต์ รวมถึงเก็บข้อมูลลง ไปในฐานข้อมูลบนเว็บไซต์ เพื่อให้ผู้ที่สนใจน าข้อมูลที่ได้ไปวิเคราะห์และใช้งานต่อได้จากการทดลอง พบว่าอุปกรณ์สามารถวัดค่าแล้วส่งข้อมูลไปเก็บบนเว็บไซต์ได้ และสามารถส่งเสียงเตือนผ่านล าโพง Buzzer ได้ ในส่วนของเว็บไซต์ก็สามารถแจ้งเตือนได้เมื่อข้อมูลที่ได้รับจากอุปกรณ์มีค่าความเสี่ยงที่จะเป็น ฮีทสโตรกสูง
ค าส าคัญ:ฮีทสโตรก,อินเตอร์เน็ตของสรรพสิ่ง, เซนเซอร์

ข

Abstract
Heatstroke is a condition caused by the body's temperature being too high. It occurs when the body temperature reaches 40 degrees Celsius or more and usually occurs in the summer or in areas with high relative humidity in the air. It is considered one of the most serious medical emergencies. It can cause harm to vital organs such as the brain, heart, lungs, kidneys, and muscles. This is because there is no notification tool which can lead to death.
This project therefore had the idea to create a heatstroke monitoring and warning system that consists of a website using Django framework and IoT device, where the device consists of a microcontroller, infrared temperature sensor, temperature and humidity sensor, Heart Rate Sensor, and Buzzer to keep track of the body temperature Ambient temperature relative humidity and heart rate to use all this information to calculate the risk of heatstroke and notify users then store information in a database on the website so that those who are interested can analyze and use the information.
Keyword: Heatstroke, IoT, Sensor

ค

สารบัญ
เรื่อง | หน้า
บทคัดย่อ | ก
Abstract | ข
สารบัญ | ค
สารบัญรูปภาพ | จ
สารบัญตาราง | ฉ

ง

จ

สารบัญรูปภาพ
เรื่อง | หน้า
รูปที่ 2.1อุปกรณ์ของDesign and Development of a Wearable Device for Heat Stroke Detection...9 รูปที่ 2.2 ผังการท างานของ Wearable Heat Stroke Detection System in IoT-based Environment...10

รูปที่ 4.8. กราฟเปรียบเทียบการอ่านค่าอัตราการเต้นของหัวใจของเครื่องวัดความดันและเซนเซอร์........27

ฉ

สารบัญตาราง
เรื่อง | หน้า

ตารางที่ 4.1. แสดงค่าอุณหภูมิที่วัดได้จากเทอร์โมมิเตอร์และเซนเซอร์พร้อมทั้งเปอร์เซ็นต์ความ

ตารางที่ 4.2. แสดงค่าอุณหภูมิที่วัดได้จากเทอร์โมมิเตอร์และเซนเซอร์พร้อมทั้งเปอร์เซ็นต์ความ

ตารางที่ 4.3. แสดงค่าความชื้นสัมพัทธ์ที่วัดได้จากไฮโกรมิเตอร์และเซนเซอร์พร้อมทั้งเปอร์เซ็นต์ความ

ตารางที่ 4.4. แสดงค่าความชื้นสัมพัทธ์ที่วัดได้จากไฮโกรมิเตอร์และเซนเซอร์พร้อมทั้งเปอร์เซ็นต์ความ

ตารางที่ 4.5. แสดงค่าอุณหภูมิภายในร่างกายที่วัดได้จากเทอร์โมมิเตอร์วัดไข้และเซนเซอร์พร้อมทั้ง

ตารางที่ 4.6. แสดงค่าอัตราการเต้นของหัวใจที่วัดได้จากเครื่องวัดความดันและเซนเซอร์พร้อมทั้ง

บทที่1
บทน า

### 1.1. ทมี่ าและความสา คัญ

ฮีทสโตรก (Heatstroke) เป็นภาวะที่เกิดจากร่างกายมีอุณหภูมิที่สูงเกินไป เกิดขึ้นเมื่อ อุณหภูมิร่างกายสูงถึง 40 องศาเซลเซียส หรือมากกว่า และมักจะเกิดในช่วงฤดูร้อนหรือบริเวณที่มี ความชื้นสัมพัทธ์ในอากาศสูง นับเป็นหนึ่งในภาวะฉุกเฉินทางการแพทย์ที่ร้ายแรง และอาจท าให้ เกิดอันตรายต่ออวัยวะส าคัญ เช่น สมอง หัวใจ ปอด ไต และกล้ามเนื้อได้ เนื่องจากประเทศไทยใน ฤดูร้อนมีอุณหภูมิสูงในหลายภูมิภาค จากข้อมูลการเฝ้าระวังเรื่องการเสียชีวิตจากภาวะอากาศ ร้อนของกองระบาดวิทยา กรมควบคุมโรค ระหว่าง มีนาคม-พฤษภาคม พ.ศ. 2558 - 2564 มี ข้อมูลผู้เสียชีวิตจากภาวะอากาศร้อนจ านวนทั้งสิ้น 234 ราย ที่เกิดจากการอยู่ในสภาพอากาศที่ ร้อนจัดเป็นเวลานานจนกระทั่งร่างกายปรับสภาพไม่ทัน การเกิดภาวะฮีทสโตรกบุคคลทั่วไปไม่ สามารถรู้ล่วงหน้าได้เลยว่าจะเกิดภาวะฮีทสโตรกเมื่อไหร่ เนื่องจากไม่มีเครื่องมือในการแจ้งเตือน ซึ่งอาจท าให้เสียชีวิตได้
โครงงานนี้จึงมีความคิดที่สร้างระบบเฝ้าระวังและแจ้งเตือนฮีทสโตรก เพื่อติดตามอุณหภูมิ ภายใน อุณหภูมิโดยรอบ ความชื้นสัมพัทธ์ และอัตราการเต้นของหัวใจเพื่อน าข้อมูลดังกล่าวไป ค านวณหาค่าความเสี่ยงที่จะเป็นฮีทสโตรก และแจ้งเตือนผู้ใช้งานรวมถึงเก็บข้อมูลลงไปใน ฐานข้อมูลบนเว็บไซต์เพื่อให้ผู้ที่สนใจน าข้อมูลที่ได้ไปวิเคราะห์และใช้งานต่อได้

### 1.2. วัตถุประสงค์

1.2.1. เพื่อออกแบบและพัฒนาระบบตรวจจับและเฝ้าระวังฮีทสโตรกที่สามารถแจ้งเตือนผู้ใช้งาน ได้
1.2.2. เพื่อเก็บข้อมูลอุณหภูมิภายในร่างกาย อุณหภูมิโดยรอบ ค่าความชื้นสัมพัทธ์ อัตราการ เต้นของหัวใจ และค านวณค่าความเสี่ยงที่จะเกิดฮีทสโตรก
1.2.3. เพื่อรวบรวมข้อมูลส าหรับผู้สนใจน าไปวิเคราะห์หรือใช้งานต่อได้

### 1.3. ขอบเขตของโครงงาน

1.3.1. ออกแบบและพัฒนาระบบแจ้งเตือนที่ประกอบไปด้วย
- อุปกรณ์ตรวจวัดที่วัดค่าได้ ดังนี้ อุณหภูมิร่างกาย ความชื้นสัมพัทธ์ อุณหภูมิโดยรอบ และอัตราการเต้นของหัวใจ ประกอบด้วยไมโครคอนโทรลเลอร์, เซนเซอร์วัดอุณหภูมิ พื้นผิว, เซนเซอร์วัดความชื้นสัมพัทธ์และอุณหภูมิโดยรอบ, เซนเซอร์วัดอัตราการเต้น ของหัวใจที่ติดไว้ที่นิ้วมือ และ Buzzer
- อุปกรณ์ตรวจวัดสามารถส่งข้อมูลที่วัดได้ไปให้ฐานข้อมูล เมื่อเซนเซอร์วัดค่าได้ค่าสูง ในระดับที่เสี่ยงต่อการเกิดฮีทสโตรกระบบจะแจ้งเตือนผู้ใช้หากมีโอกาสเกิดฮีทสโตรก ผ่านเสียงด้วย Buzzer มี 2 ระดับดังนี้
- ค่าความเสี่ยงสูง ใช้เสียงความถี่สูงส่งเสียงและหยุดเป็นระยะ
- ค่าความเสี่ยงสูงมาก ใช้เสียงความถี่สูงส่งเสียงต่อเนื่อง
- เว็บไซต์แสดงผลระดับความเสี่ยงและกราฟของข้อมูลที่วัดได้จากอุปกรณ์ตรวจวัด
- วิเคราะห์ ค านวณค่าความเสี่ยงในการเกิดฮีทสโตรก แบ่งเป็นระดับ 4 ระดับ
- ความเสี่ยงระดับปกติ
- ความเสี่ยงระดับปานกลาง
- ความเสี่ยงระดับสูง
- ความเสี่ยงระดับสูงมาก
1.3.2. แสดงผลผ่านเว็บไซต์ด้วย Django framework ประกอบด้วยหน้าดังนี้
- หน้า Sign up สามารถให้ผู้ที่สนใจสมัครมาเป็นผู้ใช้งานทั่วไปได้
- หน้า Login สามารถเข้าสู่ระบบและใช้ฟังก์ชั่น Notificationได้
- หน้า Home เป็นหน้าแรกของเว็บไซต์
- หน้า Display data แสดงกราฟและสถานะความเสี่ยงที่ได้รับมาจากอุปกรณ์
- หน้า Latest data แสดงผลข้อมูลล่าสุดที่เก็บค่าได้ถ้าผู้ใช้เข้าสู่ระบบ
- หน้า Risk infoแสดงข้อมูลเกี่ยวกับการค านวณหาค่าความเสี่ยง
1.3.3. ระบบจะรองรับผู้ใช้งาน 2 ประเภทดังนี้
- ผู้ใช้งานทั่วไป สามารถดูข้อมูลดังต่อไปนี้

- ค่าความเสี่ยง ค่าอุณหภูมิภายในร่างกาย ค่าอุณหภูมิโดยรอบ ค่าความชื้น สัมพัทธ์ ณ ขณะนั้น
- กราฟอุณหภูมิโดยรอบ ค่าความชื้นสัมพัทธ์ อุณหภูมิจากผิวหนัง และอุณหภูมิ โดยรอบและอุณหภูมิจากผิวหนังในกราฟเดียวกัน
- อุณหภูมิโดยรอบเฉลี่ย ค่าความชื้นสัมพัทธ์เฉลี่ย อุณหภูมิจากผิวหนังเฉลี่ย ค่า ความเสี่ยงเฉลี่ย
- ผู้ดูและระบบ สามารถดูข้อมูลดังต่อไปนี้
- ข้อมูลของผู้ใช้งานแต่ละคน
- ข้อมูลย้อนหลังของแต่ละผู้ใช้งาน

### 1.4. ประโยชนท์ คี่ าดว่าจะได้รับ

1.4.1. ได้ระบบแจ้งเตือนฮีทสโตรกที่แจ้งเตือนผู้ใช้งานผ่านอุปกรณ์ตรวจวัดและเว็บไซต์ที่ แสดงผลเป็นระดับความเสี่ยงและกราฟของข้อมูลที่วัดได้จากอุปกรณ์ตรวจวัด
1.4.2. ได้กราฟที่ระบุแนวโน้มของข้อมูลที่ได้จากอุปกรณ์ตรวจวัด ท าให้สามารถวิเคราะห์โอกาส ในการเกิดภาวะฮีทสโตรกได้ง่ายขึ้น
1.4.3. ได้ข้อมูลเกี่ยวกับฮีทสโตรก เช่น อัตราการเต้นของหัวใจ อุณหภูมิภายในร่างกาย ความชื้นสัมพัทธ์และ อุณหภูมิโดยรอบ ซึ่งเป็นข้อมูลพื้นฐานให้ผู้ที่สนใจน าไปวิเคราะห์ และใช้งานต่อได้

### 1.5. ตารางด าเนินงาน

ระยะเวลาการ ด าเนินงาน | สิงหาคม | กันยายน | ตุลาคม | พฤศจิกายน | ธันวาคม | มกราคม | กุมภาพันธ์
1 | 2 | 3 | 4 | 1 | 2 | 3 | 4 | 1 | 2 | 3 | 4 | 1 | 2 | 3 | 4 | 1 | 2 | 3 | 4 | 1 | 2 | 3 | 4 | 1 | 2 | 3 | 4
1.ศึกษาความ เป็นไปได้และ ก าหนดหัวข้อ โครงงาน

2.ศึกษางานวิจัยที่ เกี่ยวข้องกับฮีทส โตรก

3.ออกแบบและ พัฒนาระบบ

4.ออกแบบและ จัดท าอุปกรณ์ ตรวจวัด

5.ออกแบบและ จัดท าส่วนแสดงผล ข้อมูล

6.ทดสอบการ ท างานของระบบ

7.ปรับปรุงแก้ไข และพัฒนา ประสิทธิภาพของ ระบบ

8.สรุปผลและเขียน รูปเล่มฉบับ สมบูรณ์

บทที่2
ทฤษฎี งานวิจัย/โครงงาน และเทคโนโลยีทเี่ กี่ยวข้องกับโครงงาน

### 2.1. อาการของฮีทสโตรก

อาการของฮีทสโตรกที่สามารถตรวจวัดได้ อุณหภูมิภายในร่างกายที่เพิ่มขึ้นมากกว่า 40 องศาเซลเซียสเกิดพร้อมอากาศร้อน ผิวแห้งและอาจท าให้เกิดอาการเพ้อ อาการชัก หรืออาการ โคม่า [1]

### 2.2. เซนเซอรว์ัดอุณหภูมิ

2.2.1. GY-906-BAA MLX90614
GY-906-BAA MLX90614 [2] คือ เซนเซอร์ที่ใช้วัดค่าอุณหภูมิแบบอินฟราเรด สามารถวัดค่าอุณหภูมิโดยรอบได้ตั้งแต่ -40 ถึง 125 °C และวัดค่าอุณหภูมิของผิววัตถุได้ ตั้งแต่ -70 ถึง 380 °C ค่าความแม่นย า ± 0.5 °C โดยมีหลักการท างานดังนี้เซนเซอร์จะวัด สเปกตรัมการแผ่รังสีอินฟราเรดจากวัตถุที่อยู่ในขอบเขตการมองเห็นของเซนเซอร์ จากนั้น ท าการแปลงค่าเป็นอุณหภูมิโดยใช้กฎของสเตฟาน-โบลทซ์มานน์ โดยที่ค่าที่ได้จะเป็น ค่าเฉลี่ยของวัตถุที่อยู่ในระยะการมองเห็นของเซนเซอร์ทั้งหมด
2.2.2. LM35
LM35 [3] คือ เซนเซอร์ที่ใช้วัดค่าอุณหภูมิแบบ IC สามารถวัดค่าอุณหภูมิได้ตั้งแต่ -55 ถึง 150 °C และมีค่าความแม่นย า ± 0.5 °C โดยมีหลักการท างานดังนี้ เซนเซอร์จะวัด ค่าโดยอ้างอิงจากแรงดันไฟฟ้า เมื่ออุณหภูมิเพิ่มขึ้นแรงดันไฟฟ้าก็จะเพิ่มขึ้นเช่นกัน โดยที่ แรงดัน 10 มิลลิโวลต์เท่ากับ 1 องศาเซลเซียส

### 2.3. เทอโมมิเตอร์วัดไข้

ใช้เพื่อวัดอุณหภูมิร่างกายแล้วน ามาเปรียบเทียบกับเซนเซอร์วัดอุณหภูมิ โดยจะท าการ ปรับค่าเซนเซอร์วัดอุณหภูมิให้ใกล้เคียงกับเทอร์โมมิเตอร์วัดไข้เพื่อให้ได้ค่าที่แม่นย าที่สุด สามารถ วัดค่าอุณหภูมิได้ตั้งแต่ 32.0 ถึง 42.0 °C และมีค่าความแม่นย า ± 0.1 °C

### 2.4. เซนเซอรว์ัดอุณหภูมิและความชืน้ สัมพัทธ์

2.4.1 BME280
BME280 [4] คือ เซนเซอร์ที่ใช้วัดความกดอากาศ อุณหภูมิและความชื้นสัมพัทธ์ใน อากาศ สามารถวัดค่าอุณหภูมิได้ตั้งแต่ -40 ถึง 85 °C ความแม่นย า ± 0.5 °C วัดค่า ความชื้นสัมพัทธ์ตั้งแต่ 0 ถึง 100 % ความแม่นย า ± 3 % และวัดค่าความกดอากาศตั้งแต่ 300 ถึง 1100 hPa ความแม่นย า ± 1 Pa
2.4.2. DHT22
DHT22 [5] คือ เซนเซอร์ที่ใช้วัดค่าอุณหภูมิและค่าความชื้นสัมพัทธ์ที่มีราคาถูก สามารถวัดค่าอุณหภูมิได้ตั้งแต่ -40 ถึง 80 °C ความแม่นย า ± 0.5 °C และวัดค่าความชื้น สัมพัทธ์ตั้งแต่ 0 ถึง 100 % ค่าความแม่นย า ± 2 ถึง5 %
2.4.3. SHT35
SHT35 [6] คือเซนเซอร์ที่ใช้วัดค่าอุณหภูมิและค่าความชื้นสัมพัทธ์สามารถวัดค่า อุณหภูมิได้ตั้งแต่ -40 ถึง 125 °C ความแม่นย า ± 0.1 °C และวัดค่าความชื้นสัมพัทธ์ตั้งแต่ 0 ถึง 100 % ค่าความแม่นย า ± 1.5 %
2.4.4. HDC1080
HDC1080 [7] คือ เซนเซอร์ที่ใช้วัดค่าอุณหภูมิและค่าความชื้นสัมพัทธ์สามารถ วัดค่าอุณหภูมิได้ตั้งแต่ -40 ถึง 125 °C ความแม่นย า ± 0.2 และวัดค่าความชื้นสัมพัทธ์ได้ ตั้งแต่ 0 ถึง 100 % ค่าความแม่นย า ± 2 %

### 2.5. เทอร์โมมิเตอร์ติดผนังแบบปรอท

ใช้เพื่อวัดอุณหภูมิในอากาศแล้วน ามาเปรียบเทียบกับเซนเซอร์วัดอุณหภูมิและความชื้น สัมพัทธ์ โดยจะท าการปรับค่าเซนเซอร์ให้ใกล้เคียงกับเทอร์โมมิเตอร์ติดผนังเพื่อให้ได้ค่าที่แม่นย า ที่สุด สามารถวัดค่าอุณหภูมิได้ตั้งแต่ -20 ถึง + 50 องศาเซลเซียส

### 2.6. ไฮโกรมิเตอร์

ใช้เพื่อวัดความชื้นสัมพัทธ์แล้วน ามาเปรียบเทียบกับเซนเซอร์วัดอุณหภูมิและความชื้น สัมพัทธ์ โดยจะท าการปรับค่าเซนเซอร์ให้ใกล้เคียงกับไฮโกรมิเตอร์เพื่อให้ได้ค่าที่แม่นย าที่สุด สามารถวัดค่าอุณหภูมิได้ตั้งแต่ -15 ถึง 50 °C และวัดค่าความชื้นสัมพัทธ์ได้ตั้งแต่ 0 ถึง 100 %

### 2.7. ESP32

ESP32 [8] คือไมโครคอนโทรลเลอร์ราคาถูก ที่ใช้พลังงานต ่า และมี Wi-Fi กับ Bluetooth ในตัว ESP32 จะใช้ Tensilica Xtensa LX6 microprocessor ในแบบ dual-core และแบบ single-core ใช้ Xtensa LX7 microprocessor แบบ dual-core หรือใช้ RISC-V microprocessor ใน แบบ single-core และรวมทั้งมี built-in antenna switch, RF balun power amplifier, low-noise receive amplifier, filters, และ power-management modules ESP32 สร้างและพัฒนาโดย บริษัท Espressif Systems ใช้เพื่อเชื่อมต่อกับเซนเซอร์ทั้งหมด และส่งข้อมูลผ่านทาง WiFi

### 2.8. Active Buzzer

Active Buzzer คือ อุปกรณ์ส่งสัญญาณเสียงโดยแปลงจากสัญญาณไฟฟ้าเป็นเสียง ใช้ เพื่อส่งเสียงแจ้งเตือนเมื่อค่าความเสี่ยงในการเกิดฮีทสโตรกถึงเกณฑ์ที่ก าหนด

### 2.9. เซนเซอร์วัดอัตราการเต้นของหัวใจ

2.9.1. XD-58C Pulse Sensor
XD-58C Pulse Sensor [9] เป็นเซ็นเซอร์วัดอัตราการเต้นของหัวใจที่สามารถใช้ งานกับไมโครคอนโทรลเลอร์ทุกชนิดได้รับการออกแบบและผลิตโดยบริษัท World Famous Electronics ใช้เพื่อวัดค่าชีพจรจากปลายนิ้วจากนั้นน ามาค านวณหาอัตราการ เต้นของหัวใจ

2.9.2. MAX30102
MAX10102 [10] เป็นเซนเซอร์วัดออกซิเจนในเลือดและอัตราการเต้นของหัวใจ สามารถวัดค่าได้จากข้อมือ นิ้วมือ หรือติ่งหู

### 2.10. เครื่องวัดความดัน

ใช้เพื่อวัดอัตราการเต้นของหัวใจแล้วน ามาเปรียบเทียบกับเซนเซอร์วัดอัตราการเต้นของ หัวใจ โดยจะท าการปรับค่าเซนเซอร์ให้ใกล้เคียงกับเครื่องวัดความดันเพื่อให้ได้ค่าที่แม่นย าที่สุด สามารถวัดค่าได้ตั้งแต่ 40 ถึง 180 ครั้ง/นาที

### 2.11. Django framework

Django framework [11] เป็นเว็บเฟรมเวิร์ก open-source ที่ใช้ภาษา python และมี สถาปัตยกรรมแบบ model–template–views ที่ได้รับการดูแลโดย Django Software Foundation ใช้เพื่อสร้างเว็บไซต์ส าหรับการแสดงผลและเก็บข้อมูลเข้าฐานข้อมูล เลือกใช้ Django framework เพราะว่าเป็น framework ที่ใช้งานง่ายใช้ร่วมกับภาษา python มีความปลอดภัยสูง มี admin interface ในตัว และใช้ฐานข้อมูล SQLite

### 2.12. งานวิจัยทเี่ กี่ยวข้อง

2.12.1. Design and Development of a Wearable Device for Heat Stroke Detection [12]

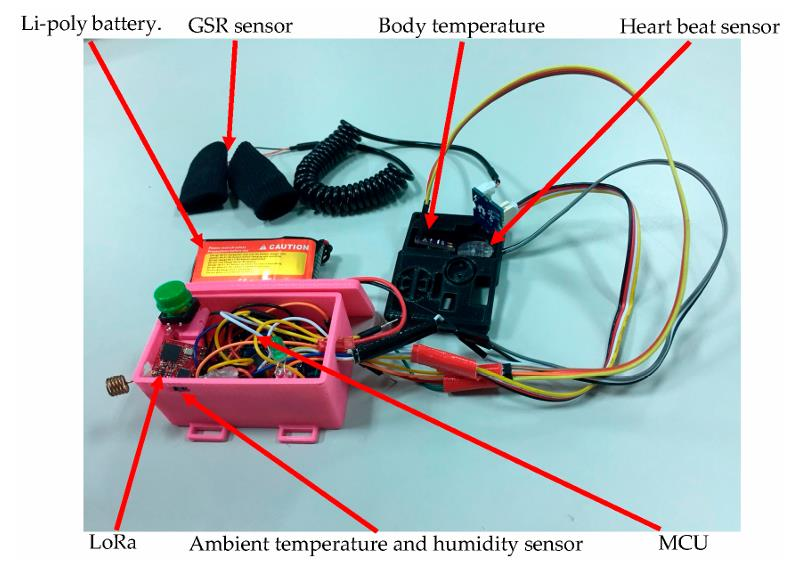
[picture p5: figure]

รูปที่ 2.1อุปกรณ์ของDesign and Development of a Wearable Device for Heat Stroke Detection
เป็นงานวิจัยของ Sheng-Tao Chen , Shih-Sung Lin , Chien-Wu Lan และ Hao-Yen Hsu มีวัตถุประสงค์เพื่อป้องกันสถานการณ์อันตรายจากฮีทสโตรกส าหรับผู้ที่ ออกก าลังกายในสภาวะอากาศร้อน งานวิจัยนี้ได้ท าการออกแบบและพัฒนาอุปกรณ์สวม ใส่เพื่อตรวจจับฮีทสโตรกโดยที่ประกอบไปด้วย เซนเซอร์วัดกระแสไฟฟ้าที่ผิวหนัง Galvanic skin response sensor เซนเซอร์วัดอุณหภูมิ MLX90614 เซนเซอร์วัดอุณหภูมิ และความชื้นสัมพัทธ์ SHT75 เซนเซอร์วัดอัตราการเต้นของหัวใจ Pulse Sensor ไมโครคอนโทรลเลอร์ Arduino Nano และ LoRa โดยอุปกรณ์สวมใส่นี้จะท าการวัดค่า กระแสไฟฟ้าที่ผิวหนัง วัดอุณหภูมิภายในร่างกาย อัตราการเต้นของหัวใจ อุณหภูมิ ภายนอก และความชื้นสัมพัทธ์ จากนั้นจะท าการส่งค่าด้วย Bluetooth ผ่าน LoRa ไปยัง อุปกรณ์ปลายทางเพื่อค านวณหาค่าความเสี่ยงที่จะเป็นฮีทสโตรกโดยใช้ fuzzy logic เมื่อ อุปกรณ์ปลายทางได้รับค่าความเสี่ยงที่จะเป็นฮีทสโตรกแล้วจะส่งค่าความเสี่ยงที่จะเป็น ฮีทสโตรกกลับไปยังอุปกรณ์สวมใส่เพื่อให้อุปกรณ์ท าการแจ้งเตือนหากมีค่าความเสี่ยงสูง โดยจะแจ้งเตือนผ่าน LED และ Buzzer

2.12.2. Wearable Heat Stroke Detection System in IoT-based Environment [13]

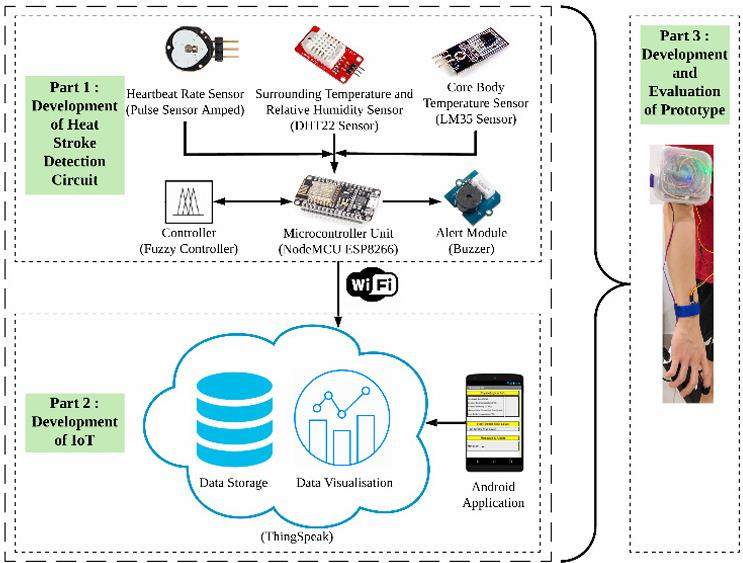
[picture p6: figure]

รูปที่ 2.2 ผังการท างานของ Wearable Heat Stroke Detection System in IoT-based Environment
เป็นงานวิจัยของ Teo Wil Sona, Dzati Athiar Ramlia และ Azniza Abd Aziza มีวัตถุประสงค์เพื่อศึกษาและพัฒนาอุปกรณ์ตรวจจับฮีทสโตรกแบบ IoT ที่สามารถสวมใส่ ได้ โดยอุปกรณ์ตรวจจับนี้สามารถวัดค่าอัตราการเต้นของหัวใจ อุณหภูมิโดยรอบ ความชื้นสัมพัทธ์ และอุณหภูมิภายในร่างกาย โดยการใช้เซนเซอร์ซึ่งค านวณค่าความ เสี่ยงที่เป็น heat Stroke ผ่าน fuzzy Controller และแจ้งเตือนผู้ใช้งานผ่าน alert module ในส่วนของ IoT จะใช้ think speak Server และ Application Android เพื่อแสดงข้อมูล ผ่านกราฟและตัวเลข ซึ่งได้ท าการทดสอบด้วยกัน 5 เฟสคือ ยืน เดิน วิ่ง เดินแล้วยืน ซึ่งได้ ผลลัพธ์คือ THSRC เป็นปัจจัยหลักที่ท าให้เกิดฮีทสโตรก ตามด้วยปัจจัยรองอีก 2 อย่าง คืออุณหภูมิภายในร่างกาย และอัตราการเต้นของหัวใจ อุปกรณ์นี้สามารถที่จะตรวจจับ ฮีทสโตรก และแจ้งเตือนผู้ใช้งานก่อนที่จะเกิดฮีทสโตรกได้ จากงานวิจัยนี้สรุปออกมาได้ว่า ฮีทสโตรกจะเกิดขึ้นก็ต่อเมื่อค่าความเสี่ยงฮีทสโตรกมากกว่า 25 และอยู่ภายใต้เงื่อนไข ของ THSRC มากกว่า 37.5 อุณหภูมิภายในร่างกายมากกว่า 38.5 องศาเซลเซียส และ อัตราการเต้นของหัวใจมากกว่า 135 ครั้ง/นาที

บทที่3
วิธีในการด าเนินโครงงาน

### 3.1. ออกแบบขั้นตอนการทา งานของระบบ

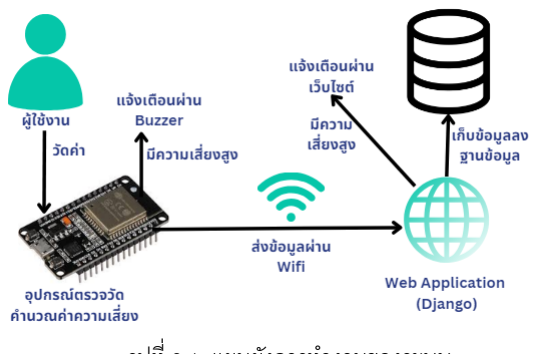
[picture p7: figure]

โครงงานนี้จะพัฒนาระบบที่ประกอบด้วยอุปกรณ์และเว็บไซต์ โดยผู้ใช้งานจะท าการวัดค่าอัตรา การเต้นของหัวใจ อุณหภูมิร่างกาย ความชื้นสัมพัทธ์ และอุณหภูมิโดยรอบ ด้วยอุปกรณ์ตรวจวัดที่ ประกอบด้วย ESP32 DHT22 MAX30102 Active Buzzer และ GY-906-BAA MLX90614 จากนั้นน าค่าที่ วัดได้มาคิดค่าความเสี่ยงที่จะเป็นฮีทสโตรก เมื่ออุปกรณ์ตรวจวัดค านวณค่าความเสี่ยงแล้วมีความเสี่ยงสูง ก็จะท าการแจ้งเตือนผ่านล าโพง Buzzer ต่อไปอุปกรณ์จะท าการส่งข้อมูลที่วัดได้รวมถึงค่าความเสี่ยงไปยัง เว็บไซต์ที่พัฒนาด้วย Django framework ผ่านสัญญาณ Wi-Fi เว็บไซต์จะท าการเก็บข้อมูลเข้าฐานข้อมูล เพื่อน ามาแสดงผลบนหน้าเว็บไซต์ และท าการแจ้งเตือนผ่านเว็บไซต์เมื่อข้อมูลที่รับเข้ามามีความเสี่ยงสูง

### 3.2. การคิดคา นวณความเสี่ยงทจี่ ะเป็นฮีทสโตรก

ในการคิดค านวณความเสี่ยงโครงงานนี้ได้ท าการดัดแปลงข้อมูลตาราง input จาก Wearable Heat Stroke Detection System in IoT-based Environment [13] ซึ่งเป็น fuzzy logic เพื่อความเข้าใจ ง่ายจึงได้ท าการแปลงเป็น crisp logic ท าการเปลี่ยนค่าอัตราการเต้นของหัวใจ จากเดิมที่อ้างอิงเป็นอัตรา การเต้นของหัวใจของคนที่ออกก าลังกาย เป็นอัตราการเต้นของหัวใจของผู้ใหญ่ทั่วไปที่ 60 ถึง 100 ครั้ง/ นาที และท าการเปลี่ยนอุณหภูมิภายในร่างกายใหม่ให้เป็นอุณหภูมิร่างกายปกติของคนทั่วไปที่ 35.4 ถึง 37.4 องศาเซลเซียส ท าให้ได้ตารางค านวณความเสี่ยงดังนี้

รูปที่ 3.1. แผนผังการท างานของระบบ

ตารางที่ 3.1.แสดง input และค่าความเสี่ยงที่จะเป็นฮีทสโตรก

Input | สถานะ | ค่าทอี่ ่าน | ค่าความเสี่ยงทจี่ ะ เป็ นฮีทสโตรก
อัตราการเต้นของหัวใจ (ครั้ง/นาที) | ปกติ ปานกลาง สูง | 60 – 100 101 – 120 ≥ 121 | 0 1 2
อุณหภูมิร่างกาย (°C) | ปกติ ปานกลาง สูง สูงมาก | 35.4 - 37.4 37.5 - 38.4 38.5 - 39.4 ≥ 39.5 | 0 1 2 3

นอกจากนั้นได้ท าการปรับ THSRC เป็น Heat index เพื่อให้เข้ากับสภาพอากาศของประเทศไทยที่ มีอุณหภูมิและความชื้นสัมพัทธ์สูง
ตารางที่ 3.2. แสดง Heat index

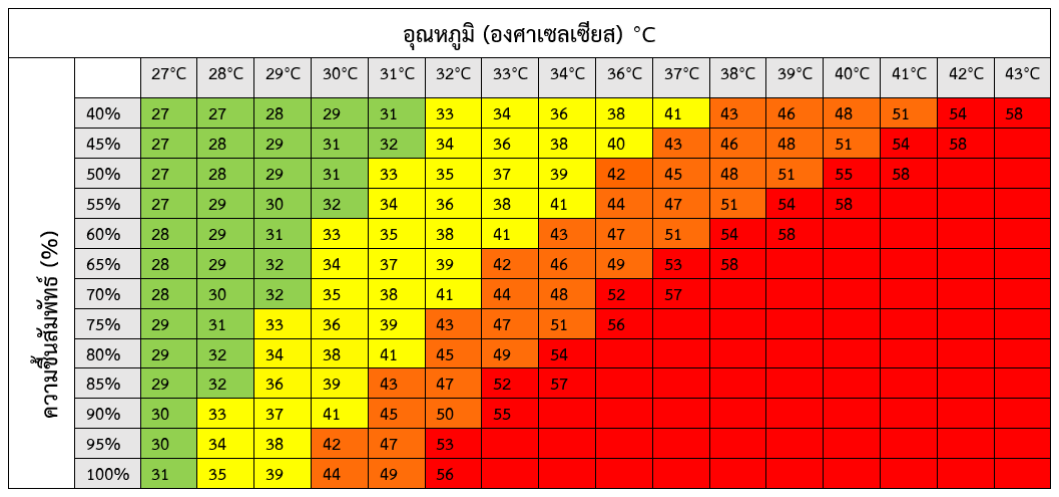
[picture p8: figure]

ที่มา: [14] http://www.rnd.tmd.go.th/heatindexanalysis/

ตารางที่ 3.3. แสดงค่าความเสี่ยงที่จะเป็นฮีทสโตรกจาก Heat index

สถานะ | สถานะ | ค่าความเสี่ยงที่จะเป็นฮีทสโตรก
| เฝ้าระวัง | 0
| เตือนภัย | 1
| อันตราย | 2
| อันตรายมาก | 3

จากนั้นท าการรวมค่าความเสี่ยงที่จะเป็นฮีทสโตรกจากตาราง 3.1 และ 3.2 แล้วท าการวิเคราะห์ว่า มีสถานะความเสี่ยงที่จะเป็นฮีทสโตรกเท่าใด โดยที่สถานะปกติมักจะเป็นผู้มีโอกาสเสี่ยงน้อย เช่น ผู้ที่อยู่ใน ห้องแอร์ ผู้ที่อยู่ในสถานะปานกลางมักจะเป็นผู้ที่อยู่ในห้องที่มีอากาศถ่ายเทและเปิดพัดลม ผู้ที่อยู่ใน สถานะสูงมักจะเป็นผู้ที่อยู่กลางแจ้งโดยที่อาจมีร่มเงาอยู่ หรือผู้ที่อยู่ในที่ที่อากาศถ่ายเทและเปิดพัดลมแต่ มีอุณหภูมิภายนอกที่สูงท าให้อุณหภูมิภายในร่างกายสูงขึ้นตาม ผู้ที่อยู่ในสถานะสูงมากมักจะเป็นผู้ที่อยู่ กลางแจ้งโดยที่ไม่มีร่มเงา

ตารางที่ 3.4. แสดงสถานะของค่าความเสี่ยงที่จะเป็นฮีทสโตรก

Output | สถานะ | ค่าความเสี่ยงที่จะเป็นฮีทส โตรก
ความเสี่ยงที่จะเป็นฮีทสโตรก | ปกติ ปานกลาง สูง สูงมาก | 0 – 2 3 - 5 5 - 6 7 - 8

โดยที่อุปกรณ์จะส่งข้อมูลจากเซนเซอร์ และค่าความเสี่ยง ไปให้เว็บไซต์เพื่อเก็บเข้าฐานข้อมูล และ เว็บไซต์จะน าข้อมูลที่ได้ไปสร้างกราฟเพื่อน าเสนอข้อมูลในรูปแบบที่เข้าใจง่าย และเมื่อฐานข้อมูลได้รับ ข้อมูลว่ามีความเสี่ยงจะมีการแจ้งเตือนผ่าน Notification บนเว็บไซต์และในส่วนของอุปกรณ์จะมีการส่ง เสียงผ่าน Buzzer ที่จะท าการแจ้งเตือนหากมีสถานะสูง และสูงมาก

### 3.3. Flowchart ของการแจ้งเตือน

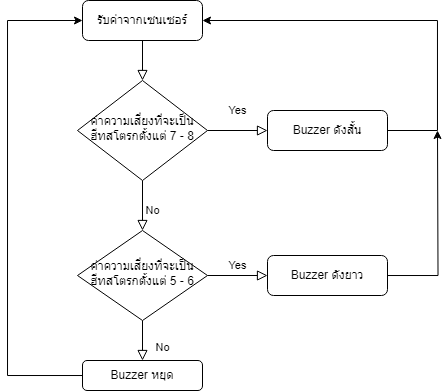
[picture p9: figure]

รูปที่ 3.2.Flowchart แสดงการแจ้งเตือนของอุปกรณ์ เมื่ออุปกรณ์อ่านค่าจากเซนเซอร์อุปกรณ์จะท าการค านวณค่าความเสี่ยง ถ้าหากว่ามีค่าความเสี่ยง ตั้งแต่ 7 ถึง 8 Buzzer จะท าการส่งเสียงสั้นและหยุดไปเรื่อย ๆจนกว่าค่าความเสี่ยงจะลดลง และเมื่อมีค่า ความเสี่ยงตั้งแต่ 5 ถึง 6 Buzzer จะท าการส่งเสียงยาวและหยุดจนกว่าค่าความเสี่ยงจะลดลง และเมื่อค่า ความเสี่ยงลดลงต ่ากว่า 5 Buzzer ก็จะหยุดส่งเสียง

### 3.4. Site map ของเว็บไซต์

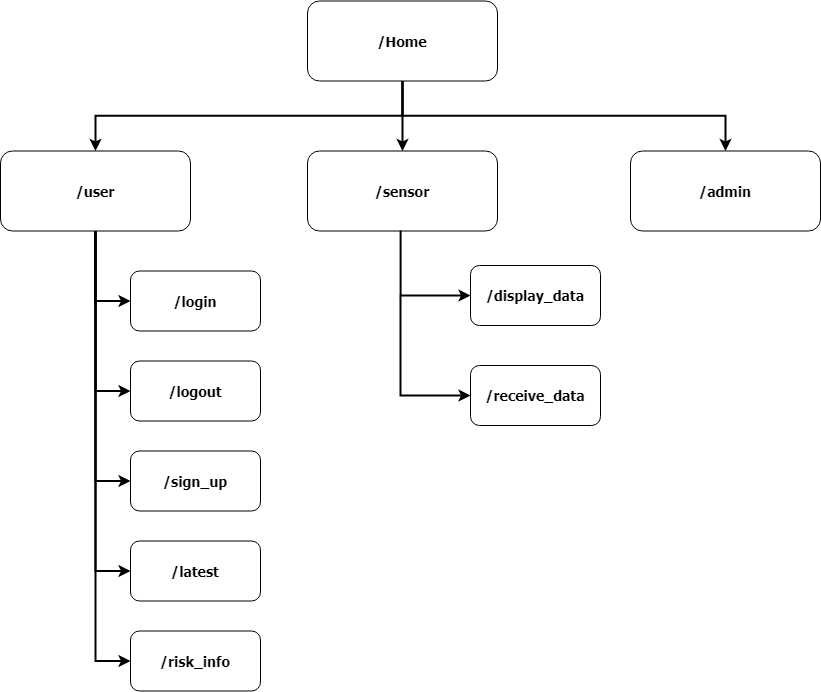
[picture p10: figure]

รูปที่ 3.3. Site map ของเว็บไซต์ เมื่อผู้ใช้งานเข้ามาที่เว็บไซต์ก็จะพบกับหน้า Home ก่อน ในหน้า Home ก็จะมีข้อมูลเกี่ยวกับ โครงงานนี้และ link ไปยังหน้าทั้งหมดยกเว้นหน้า admin เมื่อผู้ใช้งานที่ไม่ได้ท าการ login จะสามารถใช้ งานหน้า login หน้า sign_up และหน้า risk_info ได้ โดยที่หน้า sign_up ผู้ใช้งานสามารถสมัคร user เว็บไซต์ได้และเข้าสู่ระบบด้วยหน้า login ในส่วนหน้า risk_info จะเป็นข้อมูลเกี่ยวกับตารางการคิด ค านวณสถานะความเสี่ยงและข้อมูลการปฏิบัติตัวเมื่อมีความเสี่ยง เมื่อผู้ใช้งานได้ท าการ login เข้ามาใน เว็บไซต์ก็จะสามารถใช้หน้า latest และ path ที่เป็น sensor ได้ ในหน้า latest จะเป็นข้อมูลล่าสุดที่วัดได้ ของผู้ใช้งาน ในส่วนหน้า display data ที่จะแสดงข้อมูลที่ได้มาจากอุปกรณ์เป็นกราฟแสดงผลของค่า ทั้งหมดและค่าเฉลี่ย ส่วนหน้า receive จะเป็นส่วนของ API ที่รับข้อมูลจากอุปกรณ์ ในส่วนของ admin จะ สามารถดูข้อมูลทั้งหมดที่เก็บอยู่ในเว็บไซต์ได้

บทที่4
ผลการด าเนินโครงงาน

### 4.1. อุปกรณ์ตรวจวัด

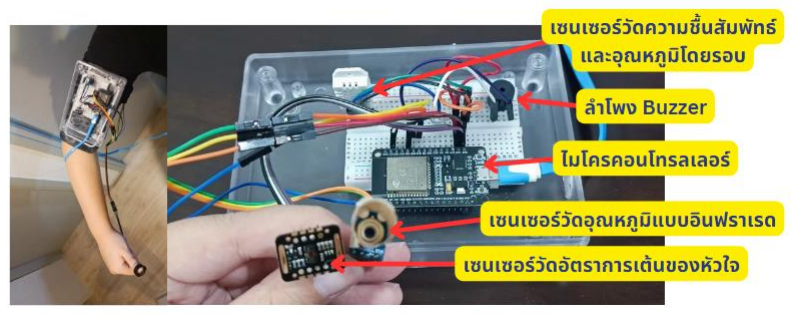
[picture p11: figure]

รูปที่ 4.1. อุปกรณ์ตรวจวัด
4.1.1. อุปกรณ์ตรวจวัดประกอบด้วย ESP32 (ไมโครคอนโทรลเลอร์) DHT22 (เซนเซอร์วัด ความชื้นสัมพัทธ์และอุณหภูมิโดยรอบ) MAX30102 (เซนเซอร์วัดอัตราการเต้นของหัวใจ) ติดไว้ที่นิ้วมือ Active Buzzer และ GY-906-BAA MLX90614 (เซนเซอร์วัดอุณหภูมิแบบ อินฟาเรด) วัดที่รักแร้
4.1.2. สามารถวัดค่าต่อไปนี้ได้อัตราการเต้นของหัวใจ อุณหภูมิภายนอก อุณหภูมิร่างกาย และ ความชื้นสัมพัทธ์และค านวณค่าความเสี่ยงที่จะเป็นฮีทสโตรก
4.1.3. สามารถส่งข้อมูลที่วัดได้ไปให้ฐานข้อมูลโดยใช้ HTTP Client

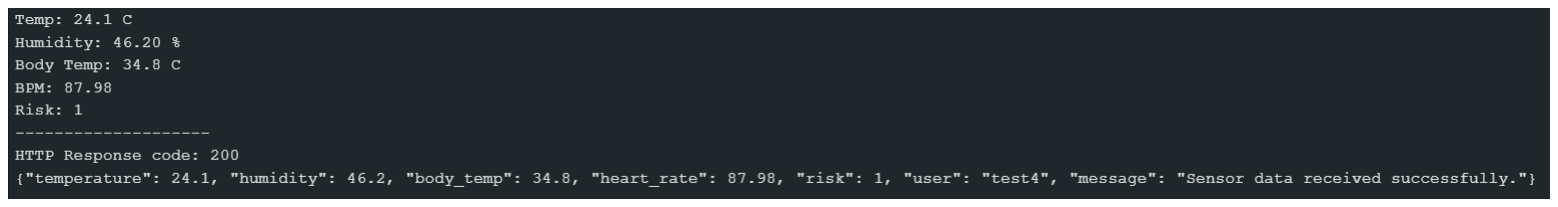
[picture p12: figure]

ข้อมูลที่ส่งจะส่งในรูปของ JSON โดยที่จะส่งค่าอัตราการเต้นของหัวใจ อุณหภูมิ ภายนอก อุณหภูมิร่างกาย ความชื้นสัมพัทธ์และค่าความเสี่ยงที่จะเป็นฮีทสโตรก
4.1.4. สามารถแจ้งเตือนผ่านเสียงด้วยล าโพง Buzzer มี 2 ระดับ
- ค่าความเสี่ยงสูง ส่งเสียงยาวและหยุดไปเรื่อย ๆจนกว่าค่าความเสี่ยงจะลดลง

รูปที่ 4.2. ตัวอย่าง HTTP respond จากการส่งข้อมูลเข้าฐานข้อมูล

- ค่าความเสี่ยงสูงมาก ส่งเสียงสั้นและหยุดไปเรื่อย ๆจนกว่าค่าความเสี่ยงจะลดลง
4.1.5. ตรวจสอบความถูกต้องของการอ่านค่าอุณหภูมิภายนอกของ DHT22 โดยการเปรียบเทียบอุณหภูมิภายนอกกับเทอร์โมมิเตอร์แบบปรอท (เนื่องจาก เทอร์โมมิเตอร์ที่น ามาใช้ในการวัดไม่สามารถวัดจุดทศนิยมได้จึงอาจท าให้เกิดการ คลาดเคลื่อน) เริ่มการตั้งค่าโดยน า DHT22 และเทอร์โมมิเตอร์มาไว้ที่จุดเดียวกัน รอจน อุณหภูมิคงที่และท าการวัดค่าที่ได้ ท าการวัดทุกๆ 20 วินาทีเป็นเวลา 1,000 วินาทีหาก ค่าที่ได้จากเซนเซอร์ DHT22 มีความคลาดเคลื่อนมากกว่า 5 เปอร์เซ็นต์จะท าการปรับให้ ใกล้เคียง
จากตารางที่ 4.1. จะเห็นได้ว่ามีข้อมูลที่มีเปอร์เซ็นต์ความคลาดเคลื่อนมากกว่า 5 เปอร์เซ็นต์อยู่ 1 ค่าซึ่งเป็นค่ามากที่สุดเท่ากับ 5.16 เปอร์เซ็นต์จึงท าการปรับค่าให้มีความ คลาดเคลื่อนน้อยที่สุด โดยการเพิ่มค่าชดเชยในส่วนที่มีความคลาดเคลื่อน

ตารางที่ 4.1. แสดงค่าอุณหภูมิที่วัดได้จากเทอร์โมมิเตอร์และเซนเซอร์พร้อมทั้งเปอร์เซ็นต์ความ คลาดเคลื่อนของเซนเซอร์

ล าดับที่ | อุณหภูมิจาก เทอร์โมมิเตอร์ (°C) | อุณหภูมิจากเซนเซอร์ (°C) | เปอร์เซ็นต์ความคลาด เคลื่อน (%)
1 | 33 | 32.5 | 1.52
2 | 33 | 32.5 | 1.52
3 | 33 | 32.5 | 1.52
4 | 33 | 32.6 | 1.21
5 | 33 | 32.6 | 1.21
6 | 33 | 32.6 | 1.21
7 | 33 | 32.6 | 1.21
8 | 33 | 32.6 | 1.21
9 | 33 | 32.6 | 1.21
10 | 33 | 32.5 | 1.52
11 | 33 | 32.5 | 1.52
12 | 33 | 32.5 | 1.52
13 | 33 | 32.5 | 1.52
14 | 33 | 32.5 | 1.52

ล าดับที่ | อุณหภูมิจาก เทอร์โมมิเตอร์ (°C) | อุณหภูมิจากเซนเซอร์ (°C) | เปอร์เซ็นต์ความคลาด เคลื่อน (%)
15 | 33 | 32.5 | 1.52
16 | 33 | 32.5 | 1.52
17 | 33 | 32.5 | 1.52
18 | 33 | 32.5 | 1.52
19 | 33 | 32.5 | 1.52
20 | 33 | 32.5 | 1.52
21 | 33 | 32.6 | 1.21
22 | 33 | 32.6 | 1.21
23 | 33 | 32.5 | 1.52
24 | 33 | 32.6 | 1.21
25 | 33 | 32.5 | 1.52
26 | 33 | 32.5 | 1.52
27 | 33 | 32.5 | 1.52
28 | 33 | 32.5 | 1.52
29 | 33 | 32.5 | 1.52
30 | 33 | 32.5 | 1.52
31 | 33 | 32.4 | 1.82
32 | 33 | 32.3 | 2.12
33 | 33 | 32.1 | 2.73
34 | 32 | 31.9 | 0.31
35 | 32 | 31.6 | 1.25
36 | 32 | 31.3 | 2.19
37 | 32 | 31 | 3.13
38 | 31 | 30.6 | 1.29
39 | 31 | 30.4 | 1.94
40 | 31 | 30.2 | 2.58
41 | 31 | 29.9 | 3.55
42 | 31 | 29.7 | 4.19
43 | 31 | 29.4 | 5.16
44 | 30 | 29.1 | 3.00
45 | 30 | 29.1 | 3.00
46 | 30 | 29 | 3.33
47 | 30 | 28.9 | 3.67
48 | 30 | 28.8 | 4.00
49 | 30 | 28.8 | 4.00
50 | 30 | 28.7 | 4.33

จากตารางที่ 4.2. จะเห็นได้ว่าเมื่อปรับค่าแล้วมีข้อมูลที่มีเปอร์เซ็นต์ความ คลาดเคลื่อนมากที่สุดจะอยู่ที่ 2.5 เปอร์เซ็นต์ซึ่งเป็นค่าความคลาดเคลื่อนที่น้อยที่สุด หลังจากปรับค่าอื่นๆ

ตารางที่ 4.2. แสดงค่าอุณหภูมิที่วัดได้จากเทอร์โมมิเตอร์และเซนเซอร์พร้อมทั้งเปอร์เซ็นต์ความ คลาดเคลื่อนของเซนเซอร์หลังปรับค่า

ล าดับที่ | อุณหภูมิจาก เทอร์โมมิเตอร์ (°C) | อุณหภูมิจากเซนเซอร์ หลังปรับค่า (°C) | เปอร์เซ็นต์ความคลาด เคลื่อน (%)
1 | 33 | 33.4 | 1.21
2 | 33 | 33.4 | 1.21
3 | 33 | 33.4 | 1.21
4 | 33 | 33.5 | 1.52
5 | 33 | 33.5 | 1.52
6 | 33 | 33.5 | 1.52
7 | 33 | 33.5 | 1.52
8 | 33 | 33.5 | 1.52
9 | 33 | 33.5 | 1.52
10 | 33 | 33.4 | 1.21
11 | 33 | 33.4 | 1.21
12 | 33 | 33.4 | 1.21
13 | 33 | 33.4 | 1.21
14 | 33 | 33.4 | 1.21
15 | 33 | 33.4 | 1.21
16 | 33 | 33.4 | 1.21
17 | 33 | 33.4 | 1.21
18 | 33 | 33.4 | 1.21
19 | 33 | 33.4 | 1.21
20 | 33 | 33.4 | 1.21
21 | 33 | 33.5 | 1.52
22 | 33 | 33.5 | 1.52
23 | 33 | 33.4 | 1.21
24 | 33 | 33.5 | 1.52
25 | 33 | 33.4 | 1.21
26 | 33 | 33.4 | 1.21
27 | 33 | 33.4 | 1.21

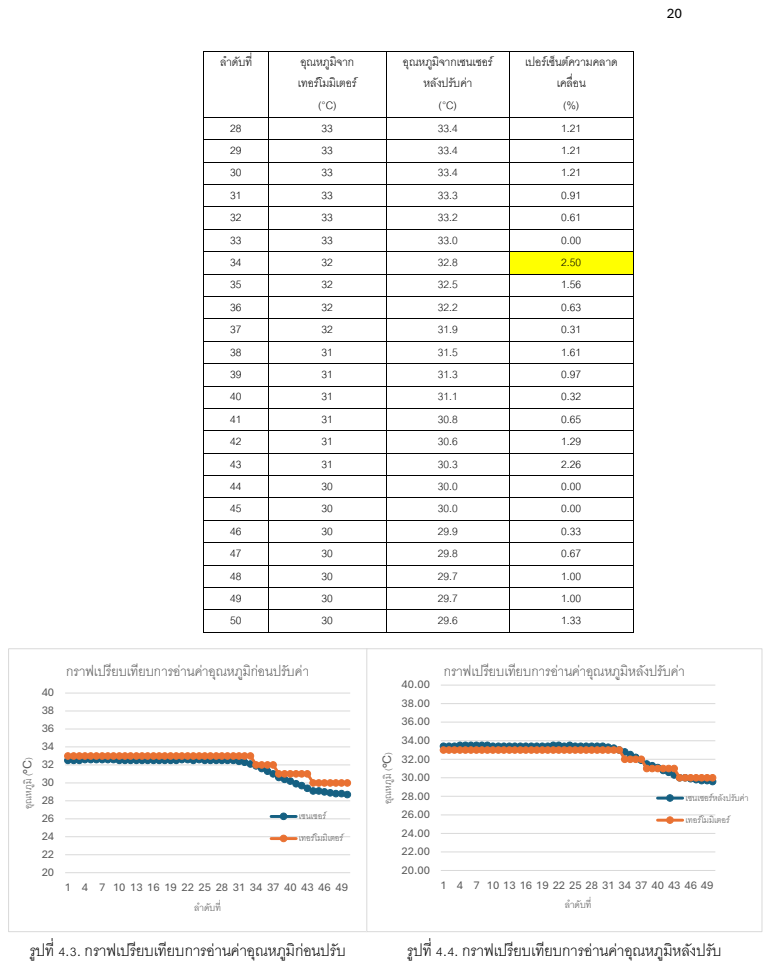
[picture p13: page 30]
อุณหภูมิ (°C); กราฟเปรียบเทียบการอ่านค่าอุณหภูมิก่อนปรับค่า; กราฟเปรียบเทียบการอ่านค่าอุณหภูมิหลังปรับค่า; รูปที่ 4.3. กราฟเปรียบเทียบการอ่านค่าอุณหภูมิก่อนปรับ; รูปที่ 4.4. กราฟเปรียบเทียบการอ่านค่าอุณหภูมิหลังปรับ

ล าดับที่ | อุณหภูมิจาก เทอร์โมมิเตอร์ (°C) | อุณหภูมิจากเซนเซอร์ หลังปรับค่า (°C) | เปอร์เซ็นต์ความคลาด เคลื่อน (%)

28 | 33 | 33.4 | 1.21
29 | 33 | 33.4 | 1.21
30 | 33 | 33.4 | 1.21
31 | 33 | 33.3 | 0.91
32 | 33 | 33.2 | 0.61
33 | 33 | 33.0 | 0.00
34 | 32 | 32.8 | 2.50
35 | 32 | 32.5 | 1.56
36 | 32 | 32.2 | 0.63
37 | 32 | 31.9 | 0.31
38 | 31 | 31.5 | 1.61
39 | 31 | 31.3 | 0.97
40 | 31 | 31.1 | 0.32
41 | 31 | 30.8 | 0.65
42 | 31 | 30.6 | 1.29
43 | 31 | 30.3 | 2.26
44 | 30 | 30.0 | 0.00
45 | 30 | 30.0 | 0.00
46 | 30 | 29.9 | 0.33
47 | 30 | 29.8 | 0.67
48 | 30 | 29.7 | 1.00
49 | 30 | 29.7 | 1.00
50 | 30 | 29.6 | 1.33

เซนเซอร์หลังปรับค่า
เทอร์โมมิเตอร์

เซนเซอร์

จากรูปที่ 4.4. กราฟหลังปรับค่าจะเห็นได้ว่าค่าของเซนเซอร์และเทอร์โมมิเตอร์มี ความใกล้เคียงและมีแนวโน้มไปในทิศทางเดียวกัน

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
20 | 52 | 51.80 | 0.38
21 | 52 | 52.10 | 0.19
22 | 52 | 51.90 | 0.19
23 | 52 | 52.10 | 0.19
24 | 52 | 51.60 | 0.77
25 | 52 | 51.60 | 0.77
26 | 52 | 51.40 | 1.15
27 | 52 | 52.60 | 1.15
28 | 52 | 52.00 | 0.00
29 | 52 | 52.60 | 1.15
30 | 51 | 51.90 | 1.76
31 | 51 | 50.00 | 1.96

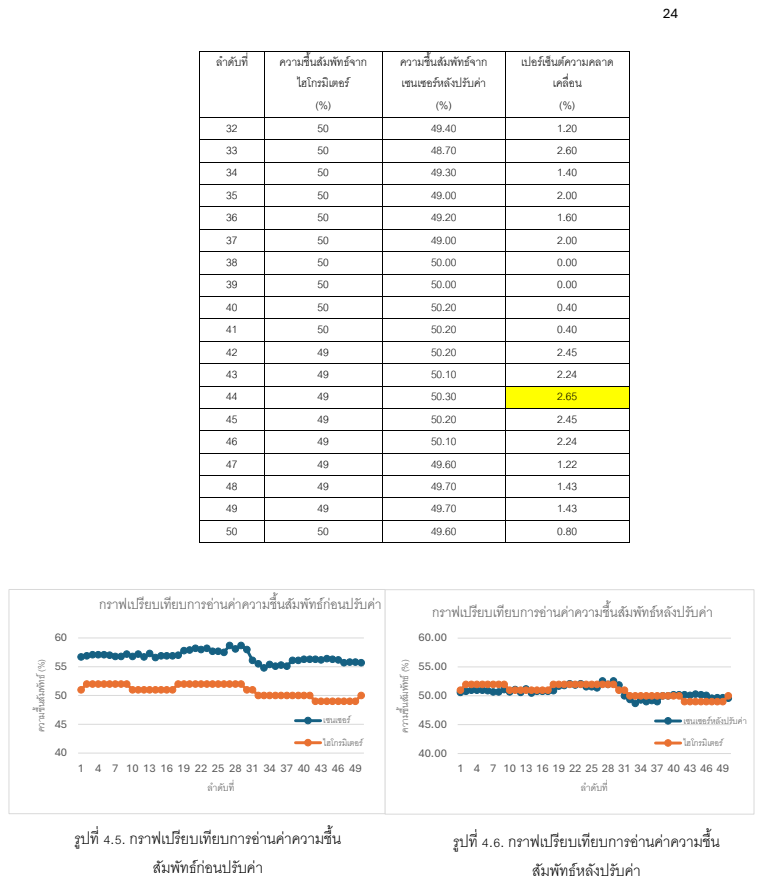
[picture p14: page 34]
เซนเซอร์; ไฮโกรมิเตอร์

ล าดับที่ | ความชื้นสัมพัทธ์จาก ไฮโกรมิเตอร์ (%) | ความชื้นสัมพัทธ์จาก เซนเซอร์หลังปรับค่า (%) | เปอร์เซ็นต์ความคลาด เคลื่อน (%)

32 | 50 | 49.40 | 1.20
33 | 50 | 48.70 | 2.60
34 | 50 | 49.30 | 1.40
35 | 50 | 49.00 | 2.00
36 | 50 | 49.20 | 1.60
37 | 50 | 49.00 | 2.00
38 | 50 | 50.00 | 0.00
39 | 50 | 50.00 | 0.00
40 | 50 | 50.20 | 0.40
41 | 50 | 50.20 | 0.40
42 | 49 | 50.20 | 2.45
43 | 49 | 50.10 | 2.24
44 | 49 | 50.30 | 2.65
45 | 49 | 50.20 | 2.45
46 | 49 | 50.10 | 2.24
47 | 49 | 49.60 | 1.22
48 | 49 | 49.70 | 1.43
49 | 49 | 49.70 | 1.43
50 | 50 | 49.60 | 0.80

กราฟเปรียบเทียบการอ่านค่าความชื้นสัมพัทธ์ก่อนปรับค่า

กราฟเปรียบเทียบการอ่านค่าความชื้นสัมพัทธ์หลังปรับค่า

ความชื้นสัมพัทธ์ (%)

เซนเซอร์หลังปรับค่า
ไฮโกรมิเตอร์

รูปที่ 4.5. กราฟเปรียบเทียบการอ่านค่าความชื้น

รูปที่ 4.6. กราฟเปรียบเทียบการอ่านค่าความชื้น

สัมพัทธ์ก่อนปรับค่า

สัมพัทธ์หลังปรับค่า

จากรูปที่ 4.6. กราฟหลังปรับค่าจะเห็นได้ว่าค่าของเซนเซอร์และไฮโกรมิเตอร์มี ความใกล้เคียงและมีแนวโน้มไปในทิศทางเดียวกัน

4.1.7. ตรวจสอบความถูกต้องของการอ่านค่าอุณหภูมิของเซนเซอร์วัดอุณหภูมิแบบอินฟราเรด ตรวจสอบโดยการเปรียบเทียบอุณหภูมิที่วัดได้กับเทอร์โมมิเตอร์วัดไข้ เริ่มการตั้ง ค่าโดยการน าเทอร์โมมิเตอร์วัดไข้มาเสียบไว้ที่รักแร้รอจนได้ค่าออกมา จากนั้นน าเซนเซอร์ มารักแร้ข้างเดียวกันโดยมีระยะห่าง 4 เซนติเมตรโดยใช้หลอดสวมรอบกับเซนเซอร์ไว้ เพื่อให้มีค่ารบกวนน้อยที่สุด รอจนเซนเซอร์วัดแล้วอุณหภูมิไม่เปลี่ยนแปลงแล้ว จากนั้น น าค่าที่ได้มาเปรียบเทียบกัน ท ำกำรวัดทุกๆ 15 นำทีเป็นเวลำ 3 ชั่วโมง หากค่าที่ได้จาก เซนเซอร์วัดอุณหภูมิแบบอินฟราเรด มีความคลาดเคลื่อนมากกว่า 5 เปอร์เซ็นต์จะท าการ ปรับให้ใกล้เคียง
จากตารางที่ 4.5. จะเห็นได้ว่ามีข้อมูลที่มีเปอร์เซ็นต์ความคลาดเคลื่อนมากที่สุด จะอยู่ที่ 0.55 เปอร์เซ็นต์ เนื่องจากมีเปอร์เซ็นต์ความคลาดเคลื่อนที่น้อยกว่า 5 เปอร์เซ็นต์ จึงไม่ได้ท าการปรับค่า

ตารางที่ 4.5. แสดงค่าอุณหภูมิภายในร่างกายที่วัดได้จากเทอร์โมมิเตอร์วัดไข้และเซนเซอร์พร้อมทั้ง เปอร์เซ็นต์ความคลาดเคลื่อนของเซนเซอร์

เทอร์โมมิเตอร์ วัดไข้ (°C) | เซนเซอร์วัดอุณหภูมิ แบบอินฟราเรด (°C) | เปอร์เซ็นต์ความคลาด เคลื่อน (%)
36.3 | 36.3 | 0.00
36.5 | 36.7 | 0.55
36.7 | 36.9 | 0.54
36.6 | 36.6 | 0.00
36.5 | 36.5 | 0.00
36.6 | 36.6 | 0.00
36.7 | 36.8 | 0.27
36.6 | 36.8 | 0.55
36.6 | 36.7 | 0.27
36.6 | 36.8 | 0.55
36.2 | 36.2 | 0.00
36.4 | 36.3 | 0.27

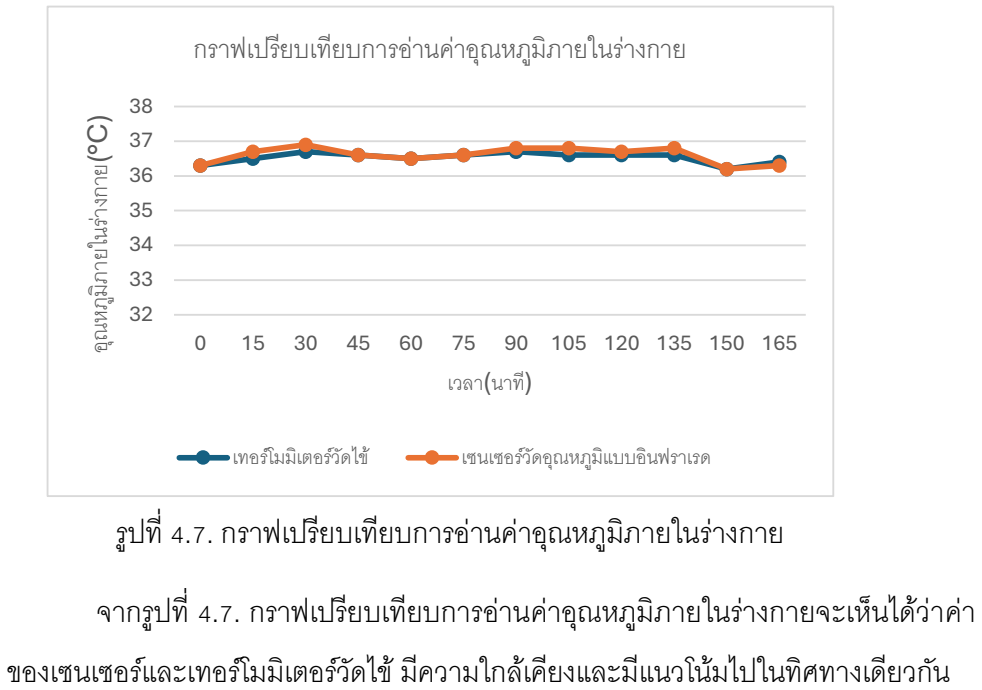
[picture p15: figure]
จากรูปที่ 4.7. กราฟเปรียบเทียบการอ่านค่าอุณหภูมิภายในร่างกายจะเห็นได้ว่าค่า ของเซนเซอร์และเทอร์โมมิเตอร์วัดไข้ มีความใกล้เคียงและมีแนวโน้มไปในทิศทางเดียวกัน; อุณหภูมิภายในร่างกาย; เวลา(นาที); กราฟเปรียบเทียบการอ่านค่าอุณหภูมิภายในร่างกาย; เทอร์โมมิเตอร์วัดไข้; เซนเซอร์วัดอุณหภูมิแบบอินฟราเรด; รูปที่ 4.7. กราฟเปรียบเทียบการอ่านค่าอุณหภูมิภายในร่างกาย

4.1.8. ตรวจสอบความถูกต้องของการอ่านค่าอัตราการเต้นของหัวใจของเซนเซอร์วัดอัตราการเต้น ของหัวใจ
ตรวจสอบโดยการเปรียบเทียบกับเครื่องวัดความดัน โดยน าปลอกแขนของ เครื่องวัดความดันใส่ไว้ที่แขนข้างใดข้างหนึ่ง น าเซนเซอร์มาสวมไว้ที่นิ้วโป้งรัดด้วยหนังยาง หรือตีนตุ๊กแกที่แขนข้างเดียวกัน จากนั้นท าการวัดค่าด้วยเครื่องวัดความดัน เมื่อวัดเสร็จน า ค่าที่ได้ไปเปรียบเทียบกับค่าที่วัดได้ของเซนเซอร์ในเวลาเดียวกัน ท าการวัดทุกๆ ครึ่งชั่วโมง เป็นเวลา 6 ชั่วโมง หากค่าที่ได้จากเซนเซอร์วัดอุณหภูมิแบบอินฟราเรด มีความคลาดเคลื่อน มากกว่า 5 เปอร์เซ็นต์จะท าการปรับให้ใกล้เคียง

จากตารางที่ 4.6. แสดงให้เห็นว่าเปอร์เซ็นต์ความคลาดเคลื่อนของเซนเซอร์สูงสุด อยู่ที่ 10.71 เปอร์เซ็นต์ซึ่งมีเปอร์เซ็นต์ความคลาดเคลื่อนเกินกว่าที่ตั้งไว้จึงท าการปรับค่า

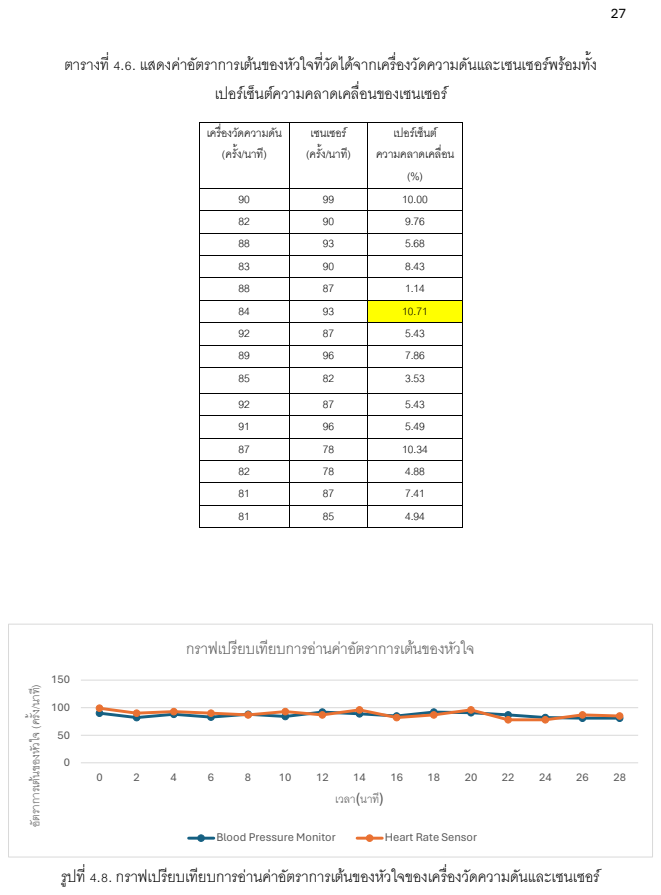
[picture p16: page 37]
เวลา(นาที); Blood Pressure Monitor; Heart Rate Sensor

ตารางที่ 4.6. แสดงค่าอัตราการเต้นของหัวใจที่วัดได้จากเครื่องวัดความดันและเซนเซอร์พร้อมทั้ง

เปอร์เซ็นต์ความคลาดเคลื่อนของเซนเซอร์

เครื่องวัดความดัน (ครั้ง/นาที) | เซนเซอร์ (ครั้ง/นาที) | เปอร์เซ็นต์ ความคลาดเคลื่อน (%)

90 | 99 | 10.00
82 | 90 | 9.76
88 | 93 | 5.68
83 | 90 | 8.43
88 | 87 | 1.14
84 | 93 | 10.71
92 | 87 | 5.43
89 | 96 | 7.86
85 | 82 | 3.53
91 | 96 | 5.49
87 | 78 | 10.34
82 | 78 | 4.88
81 | 87 | 7.41
81 | 85 | 4.94

กราฟเปรียบเทียบการอ่านค่าอัตราการเต้นของหัวใจ

อัตราการเต้นของหัวใจ (ครั้ง/นาที)

รูปที่ 4.8. กราฟเปรียบเทียบการอ่านค่าอัตราการเต้นของหัวใจของเครื่องวัดความดันและเซนเซอร์

จากรูปที่ 4. 8. กราฟมีแนวโน้มค่าที่คลาดเคลื่อนไม่ไปในทิศทางเดียวกัน ท าให้เมื่อ ปรับค่าแล้วยังมีเปอร์เซ็นต์ความคลาดเคลื่อนที่สูงอยู่ซึ่งไม่อาจหลีกเลี่ยงได้จึงไม่ได้ท าการ ปรับค่า

4.1.9. ท าการทดลองเพื่อวัดผลว่าอุณหภูมิภายนอกส่งผลต่ออุณหภูมิภายในร่างกายหรือไม่ โดยใช้เซนเซอร์ DHT 22 และเซนเซอร์วัดอุณหภูมิแบบอินฟราเรด เริ่มการทดลอง โดยการนั่งรอจนอุณหภูมิร่างกายคงที่ จากนั้นจึงท าการวัดค่าและบันทึกผลทุกๆ 20 วินาที เป็นเวลา 10 นาที

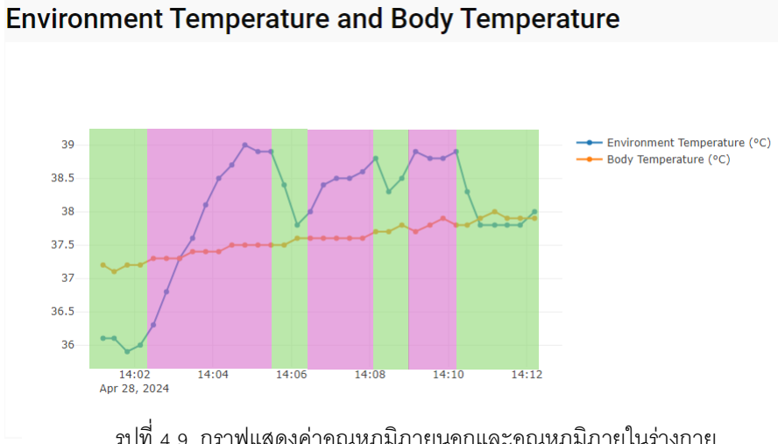
[picture p17: figure]

จากรูปที่ 4.9. ผู้ทดลองได้ท าการทดลองในขณะที่แดดจ้าและมีร่มเงา โดยที่เวลาที่เข้าร่มเงาจะอยู่ ในช่วงของสีเขียว และออกแดดในช่วงสีม่วง จากการทดลองท าให้เห็นว่าอุณหภูมิภายนอกที่สูงขึ้นมีผล เล็กน้อยที่ท าให้อุณหภูมิภายในสูงขึ้นด้วย สาเหตุที่อุณหภูมิภายในร่างกายเพิ่มขึ้นอย่างคงที่เพราะกลไก การควบคุมอุณหภูมิของร่างกายยังคงรักษาอุณหภูมิภายในให้สม ่าเสมอ

รูปที่ 4.9. กราฟแสดงค่าอุณหภูมิภายนอกและอุณหภูมิภายในร่างกาย

### 4.2. เว็บไซต์

4.1.10. หน้า Home

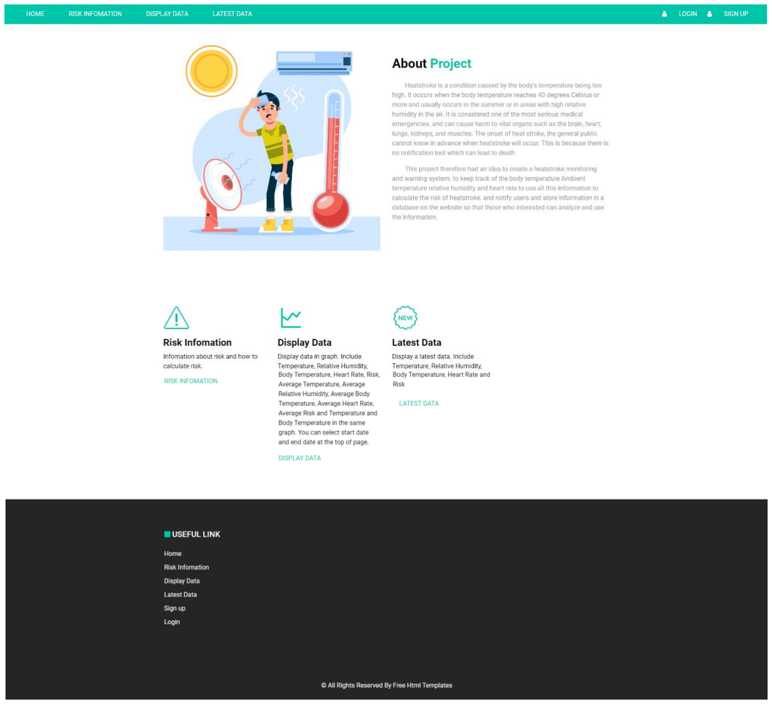
[picture p18: figure]

แสดงข้อมูลเกี่ยวกับโครงงานนี้และลิงก์ไปยังหน้า Home หน้า Risk Information หน้า Display Data หน้า Latest Data หน้า Sign up และหน้า Login

รูปที่ 4.10. หน้า Home

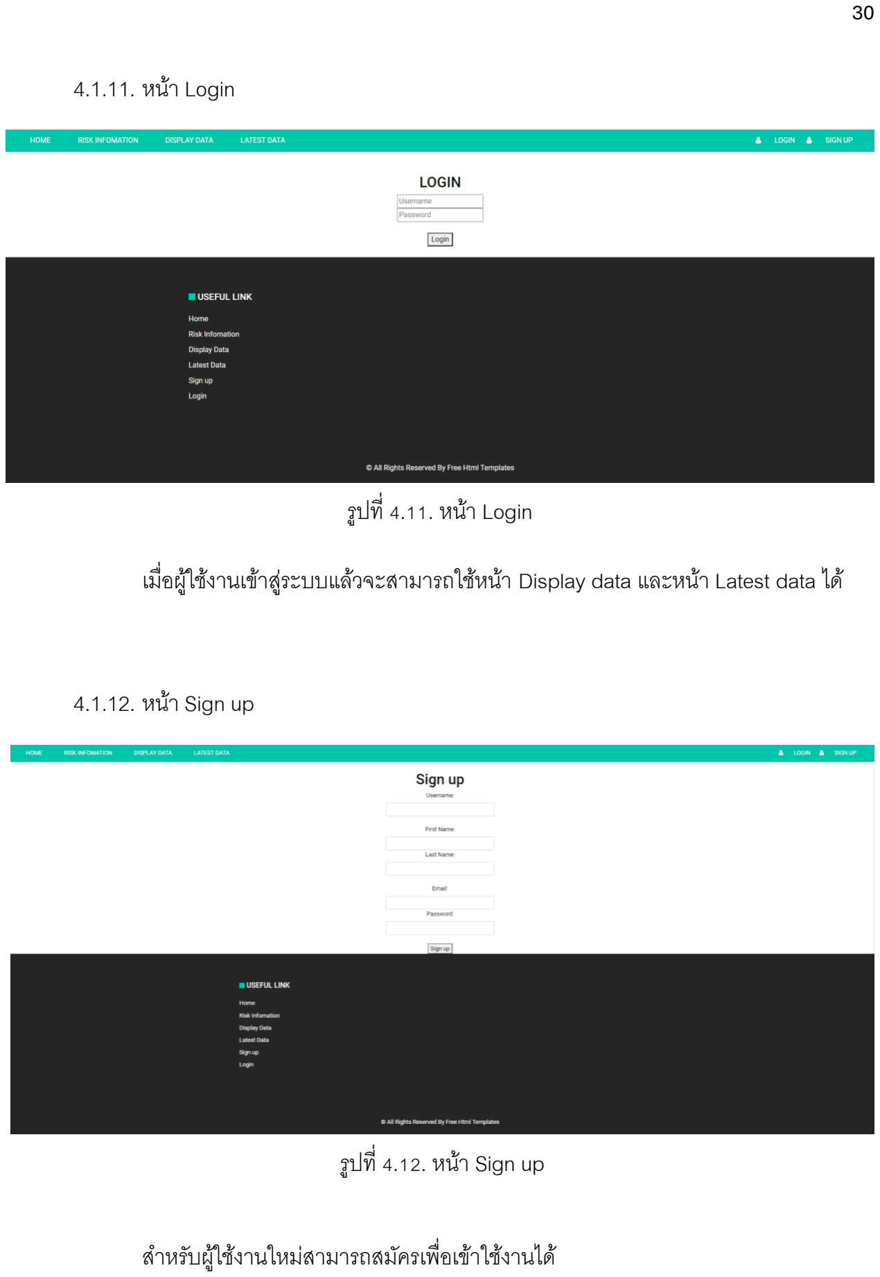
[picture p19: page 40]

4.1.11. หน้า Login

เมื่อผู้ใช้งานเข้าสู่ระบบแล้วจะสามารถใช้หน้า Display data และหน้า Latest data ได้

4.1.12. หน้า Sign up

ส าหรับผู้ใช้งานใหม่สามารถสมัครเพื่อเข้าใช้งานได้

รูปที่ 4.11. หน้า Login

รูปที่ 4.12. หน้า Sign up

4.1.13. หน้า Latest data

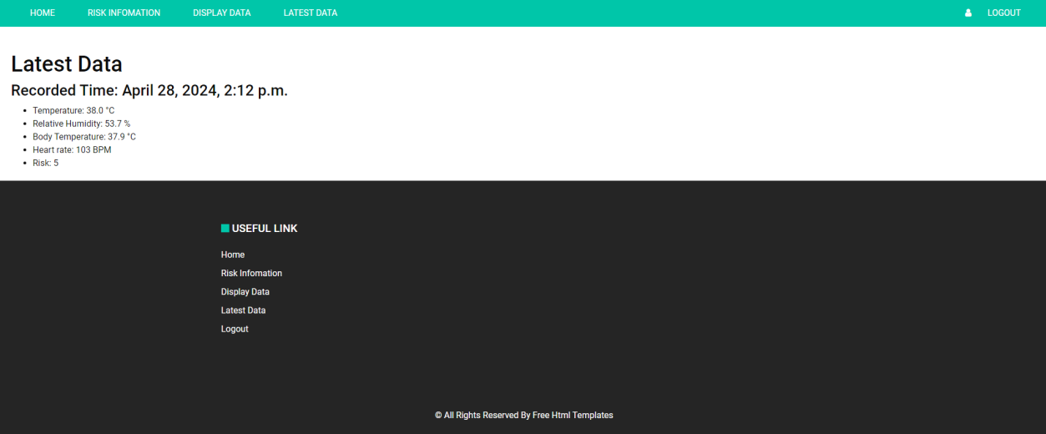
[picture p20: figure]

แสดงผลข้อมูลที่บันทึกล่าสุดที่อ่านค่าได้จากอุปกรณ์ตรวจวัดแยกแต่ละผู้ใช้งาน โดยจะแสดงผลก็ต่อเมื่อผู้ใช้งานเข้าสู่ระบบ

รูปที่ 4.13. หน้า Latest data

4.1.14. หน้า Risk Information

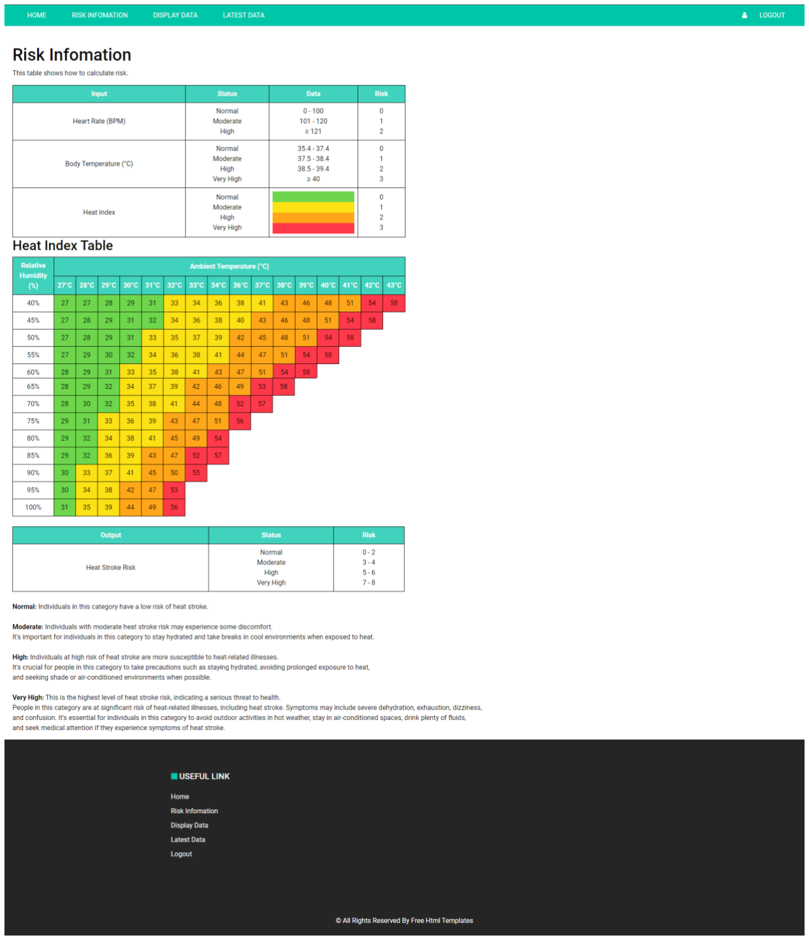
[picture p21: figure]

มีตารางแสดงข้อมูลเกี่ยวกับการคิดค านวณความเสี่ยง พร้อมข้อมูลการปฏิบัติตน เมื่อมีความเสี่ยง

รูปที่ 4.14 หน้า Risk Information

4.1.15. หน้า Display data

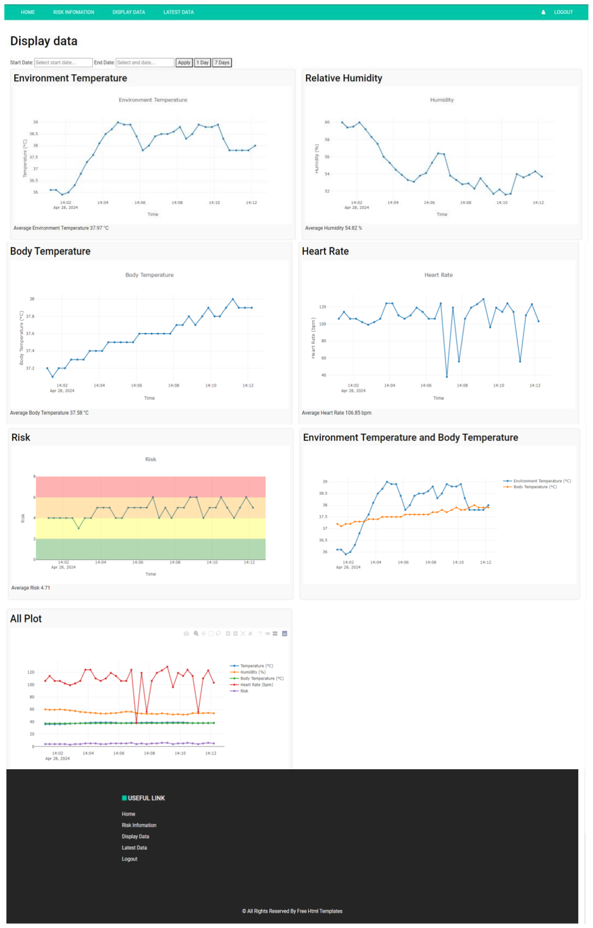
[picture p22: figure]

รูปที่ 4.15. หน้า Display data

มีกราฟแสดงผลพร้อมค่าเฉลี่ยของค่าต่อไปนี้ อุณหภูมิโดยรอบ ค่าความชื้นสัมพัทธ์ อุณหภูมิภายในร่างกาย ค่าความเสี่ยงที่จะเป็นฮีทสโตรก อุณหภูมิโดยรอบและอุณหภูมิ ภายในร่างกายในกราฟเดียวกัน และกราฟของค่าทั้งหมดในกราฟเดียวกัน โดยแยกแต่ละ ผู้ใช้งาน โดยที่กราฟแสดงค่าความเสี่ยงที่จะเป็นฮีทสโตรกจะแบ่งแถบสีตามความเสี่ยงตาม ตารางที่ 3.2.3.

4.1.16. การแจ้งเตือนบนเว็บไซต์

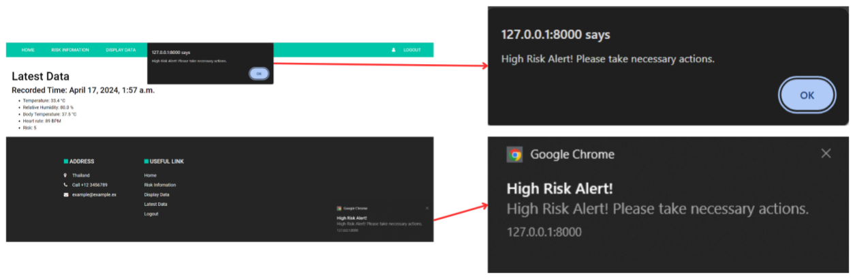
[picture p23: figure]

เมื่อข้อมูลที่ได้รับจากอุปกรณ์ตรวจวัดมีค่าความเสี่ยงที่จะเป็นฮีทสโตรกสูงหรือสูงมาก เว็บไซต์จะท าการแจ้งเตือน โดยจะมีการแจ้งเตือน 2 แบบด้วยกันคือ 1. แบบ JavaScript alert 2. แบบ local notification

รูปที่ 4.16. ตัวอย่างการแจ้งเตือนบนเว็บไซต์

บทที่5
สรุปและข้อเสนอแนะ

### 5.1. สรุปผลโครงงาน

โครงงานนี้ได้พัฒนาระบบแจ้งเตือนฮีทสโตรกที่วัดค่าจากอุปกรณ์ตรวจวัดที่ประกอบไปด้วย Esp32 DHT22 Max30102 Active buzzer และ GY-906-BAA MLX90614 แล้วน าค่าที่วัดได้ ไปค านวณ เป็นค่าความเสี่ยงที่จะเป็นฮีทสโตรก และแจ้งเตือน ผ่าน buzzer เมื่อมีค่าความเสี่ยงที่จะเป็นฮีทสโตรกสูง จากนั้นน าข้อมูลที่ได้ไปบันทึกลงฐานข้อมูลและแสดงบนเว็บไซต์พร้อมแจ้งเตือนเมื่อมีค่าความเสี่ยงที่จะ เป็นฮีทสโตรกสูง โดยที่เว็บไซต์แสดงข้อมูลเป็นกราฟของอุณหภูมิภายในร่างกาย อุณหภูมิภายนอก ความชื้นสัมพัทธ์ ค่าความเสี่ยงที่เป็นฮีทสโตรก และอัตราการเต้นของหัวใจ

### 5.2. ปัญหาและอุปสรรค

5.2.1.ปัญหาการแจ้งเตือนไม่สามารถแจ้งเตือน push notification ผ่าน firebase 5.2.2.ปัญหาเซนเซอร์วัดอัตราการเต้นของหัวใจ MAX30100(สีม่วง) และXD-58C Pulse Sensor ไม่สามารถใช้งานได้
5.2.3.ปัญหาเซนเซอร์วัดอัตราการเต้นของหัวใจไม่สามารถอ่านค่าได้ถูกต้องถ้าสวมใส่แน่นหรือ หลวมเกินไป
5.2.4.ไม่สามารถแจ้งเตือนในมือถือได้

### 5.3. การพัฒนาในอนาคต

5.3.1. พัฒนาเป็นแอปพลิเคชันมือถือเพื่อเข้าถึงผู้ใช้งานได้ง่ายและสะดวกขึ้น 5.3.2.ขอความเห็นจากแพทย์เพื่อให้สามารถพัฒนาระบบแจ้งเตือนได้แม่นย ามากขึ้น
5.3.3. เพิ่มกลุ่มตัวอย่างในการทดลองใช้งานอุปกรณ์จริง เพื่อให้ได้สถานการณ์จริงที่หลากหลาย มากขึ้น

บรรณานุกรม
[1] D. Ruthirago and P. Laengvejkal, “Be careful of heatstroke – a potentially life-threatening
form of heat illness | Bangkok International Hospital,” www.bangkokinternationalhospital.com.
https://www.bangkokinternationalhospital.com/health-articles/disease-treatment/hot-weather-must-be-careful-of-heatstroke (accessed Nov. 13, 2023).
[2] Mouser Electronics, “MLX90614 family,” Mouser Electronics. https://th.mouser.com/ProductDetail/Melexis/MLX90614ESF-BAA-000-TU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 (https://th.mouser.com/ProductDetail/Melexis/MLX90614ESF-BAA-000-TU?qs=KuGPmAKtFKVScNDmoJmFVw%3D%3D) (accessed Nov. 20, 2023).
[3] Texas Instruments, “LM35 data sheet, product information and support | TI.com,” Ti.com,
2017. https://www.ti.com/product/LM35 (accessed Nov. 20, 2023).
[4] Bosch Sensortec GmbH, “BME280 sensor API,” GitHub, Nov. 03, 2023. https://github.com/BoschSensortec/BME280_driver (accessed Nov. 20, 2023).
[5] Adafruit Industries, “DHT22 temperature-humidity sensor + extras,” Adafruit.com, 2019. https://www.adafruit.com/product/385 (accessed Nov. 20, 2023).
[6] Sensirion AG, “SHT35-DIS-F,” sensirion.com. https://sensirion.com/products/catalog/SHT35-DIS-F (accessed Nov. 20, 2023).

[7]Texas Instruments Incorporated, “HDC1080 data sheet, product information and support | TI.com,” www.ti.com. https://www.ti.com/product/HDC1080 (accessed Nov. 20, 2023).

[8] Espressif, “ESP32 Series Datasheet .” Available: https://www.espressif.com/sites/default/files/documentation/esp32_datasheet_en.pdf (accessed Nov. 20, 2023).

[9] World Famous Electronics LLC, “WorldFamousElectronics/PulseSensorPlayground,” GitHub, May 19, 2023. https://github.com/WorldFamousElectronics/PulseSensorPlayground (accessed Nov. 20, 2023).
[10] Analog Devices, “MAX30102 High-Sensitivity Pulse Oximeter and Heart-Rate Sensor for
Wearable Health | Analog Devices,” Analog.com, 2018.
https://www.analog.com/en/products/max30102.html (accessed Nov. 20, 2024).
[11] Django, “Django,” Django Project. https://docs.djangoproject.com/en/4.2/ (accessed Nov. 20, 2023).
[12] S.-T. Chen, S.-S. Lin, C.-W. Lan, and H.-Y. Hsu, “Design and Development of a Wearable Device for Heat Stroke Detection,” Sensors, vol. 18, no. 2, p. 17, Dec. 2017, doi: https://doi.org/10.3390/s18010017 (accessed Nov. 13, 2023).
[13] T. W. Son, D. A. Ramli, and A. A. Aziz, “Wearable Heat Stroke Detection System in IoT-based Environment,” Procedia Computer Science, vol. 192, pp. 3686–3695, 2021, doi: https://doi.org/10.1016/j.procs.2021.09.142 (accessed Nov. 13, 2023).
[14] M. I. R. and D. THAI METEOROLOGICAL DEPARTMENT, “Heat Index R&D TMD,” www.rnd.tmd.go.th. http://www.rnd.tmd.go.th/heatindexanalysis/ (accessed Feb. 5, 2024).
[15] S.-S. Lin, C.-W. Lan, H.-Y. Hsu, and S.-T. Chen, “Data Analytics of a Wearable Device for Heat Stroke Detection,” Sensors, vol. 18, no. 12, p. 4347, Dec. 2018, doi: https://doi.org/10.3390/s18124347 (accessed Feb. 5, 2024).
[16] SYNPHAET HOSPITAL, “โรคฮีทสโตรก (Heat Stroke) หรือโรคลมแดด - โรงพยาบาลสินแพทย์,” โรงพยาบาลสินแพทย์, Mar. 28, 2023. https://www.synphaet.co.th/%E0%B9%82%E0%B8%A3%E0%B8%84%E0%B8%AE%E0%B8 %B5%E0%B8%97%E0%B8%AA%E0%B9%82%E0%B8%95%E0%B8%A3%E0%B8%81-

heat-stroke-
%E0%B8%AB%E0%B8%A3%E0%B8%B7%E0%B8%AD%E0%B9%82%E0%B8%A3%E0%B 8%84%E0%B8%A5%E0%B8%A1/(accessed Feb. 5, 2024).
[17] ส านักงานป้องกันควบคุมโรคที่ 7ขอนแก่น, “แพทย์เตือน ภาวะเจ็บป่ วยจากลมร้อน ‘ฮีทสโตรก’ เสี่ยงอาการรุนแรง และอาจเสียชีวิตได้,” ddc.moph.go.th, Mar. 25, 2022. https://ddc.moph.go.th/odpc7/news.php?news=24196&deptcode=odpc7&news_views=427 2 (https://ddc.moph.go.th/odpc7/news.php?news=24196&deptcode=odpc7&news_views=4272) (accessed Nov. 20, 2023).
[18] Centers for Disease Control and Prevention, “Frequently Asked Questions (FAQ) About
Extreme Heat | Natural Disasters and Severe Weather | CDC,” www.cdc.gov, Apr. 14, 2020.
https://www.cdc.gov/disasters/extremeheat/faq.html#:~:text=Heat%20stroke%20is%20the%2 0most (https://www.cdc.gov/disasters/extremeheat/faq.html#:~:text=Heat%20stroke%20is%20the%20most) (accessed Feb. 5, 2024).

[19]T. Durongbhandhu, “โรคลมร้อน (Heat Stroke) ,” Thailand Digital Journal, Oct. 2019. https://thaidj.org/index.php/CHJ/article/download/7412/7641/11666 (accessed Feb. 5, 2024).

[20] Adafruit, “adafruit/DHT-sensor-library,” GitHub, May 04, 2020. https://github.com/adafruit/DHT-sensor-library (accessed Nov. 20, 2023).
[21] โรงพยาบาลศิครินทร์, “วิธีเช็ดตัว ‘ลดไข้’ ที่ถูกต้อง ควรท าอย่างไร ? - โรงพยาบาลศิครินทร์,” โรง พยาบาลศิครินทร์, Aug. 19, 2021. https://www.sikarin.com/health/%e0%b8%a7%e0%b8%b4%e0%b8%98%e0%b8%b5%e0%b9%80%e0%b8%8a%e0%b9%87%e0%b8%94%e0%b8%95%e0%b8%b1%e0%b8%a7-%e0%b8%a5%e0%b8%94%e0%b9%84%e0%b8%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 (accessed Feb. 5, 2024).
