6310611030/Heatstroke-Project/Documents/บทคัดย่อ.pdf

บทคัดย่อ
ฮีทสโตรกเป็นภาวะที่เกิดขึ้นเมื่อร่างกายมีอุณหภูมิที่สูงเกินไปจนกระทั่งร่างกายปรับสภาพไม่ทัน เกิดจาก การอยู่ในสภาพอากาศที่ร้อนจัดเป็นเวลานานซึ่งอาจท าให้เสียชีวิตได้ ในปัจจุบันยังไม่มีเครื่องมือที่ใช้ในการ แจ้งเตือนการเกิดภาวะฮีทสโตรก โครงงานนี้จึงสร้างระบบเฝ้าระวังและแจ้งเตือนฮีทสโตรก ที่ประกอบด้วย เว็บไซต์ที่ใช้ Django Framework และอุปกรณ์ IoT โดยที่อุปกรณ์ประกอบด้วยไมโครคอนโทรลเลอร์เซนเซอร์ วัดอุณหภูมิแบบอินฟราเรด เซนเซอร์วัดความชื้นสัมพัทธ์และอุณหภูมิโดยรอบ เซนเซอร์วัดอัตราการเต้นของ หัวใจ และล าโพง Buzzer โดยอุปกรณ์สามารถวัดค่าอุณหภูมิภายใน อุณหภูมิโดยรอบ ความชื้นสัมพัทธ์ และ อัตราการเต้นของหัวใจ เพื่อน าข้อมูลดังกล่าวไปค านวณหาค่าความเสี่ยงที่จะเป็นฮีทสโตรก และแจ้งเตือน ผู้ใช้งานผ่านล าโพง Buzzer และเว็บไซต์ รวมถึงเก็บข้อมูลลงไปในฐานข้อมูลบนเว็บไซต์ เพื่อให้ผู้ที่สนใจน า ข้อมูลที่ได้ไปวิเคราะห์และใช้งานต่อได้จากการทดลองพบว่าอุปกรณ์สามารถวัดค่าแล้วส่งข้อมูลไปเก็บบน เว็บไซต์ได้ และสามารถส่งเสียงเตือนผ่านล าโพง Buzzer ได้ ในส่วนของเว็บไซต์ก็สามารถแจ้งเตือนได้เมื่อ ข้อมูลที่ได้รับจากอุปกรณ์มีค่าความเสี่ยงที่จะเป็นฮีทสโตรกสูง
ค ำส ำคัญ:ฮีทสโตรก,อินเตอร์เน็ตของสรรพสิ่ง, เซนเซอร์
