6310611030/Heatstroke-Project/(commit log)

2024-11-12 Bump django in /Heatstroke/heatstroke_warning_system
    Bumps [django](https://github.com/django/django) from 4.2.5 to 4.2.16.
    - [Commits](https://github.com/django/django/compare/4.2.5...4.2.16)
    ---
    updated-dependencies:
    - dependency-name: django
    dependency-type: direct:production
    ...
2024-11-12 Bump sqlparse in /Heatstroke/heatstroke_warning_system
    Bumps [sqlparse](https://github.com/andialbrecht/sqlparse) from 0.4.4 to 0.5.0.
    - [Changelog](https://github.com/andialbrecht/sqlparse/blob/master/CHANGELOG)
    - [Commits](https://github.com/andialbrecht/sqlparse/compare/0.4.4...0.5.0)
    - dependency-name: sqlparse
    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
2024-11-12 Bump cryptography in /Heatstroke/heatstroke_warning_system
    Bumps [cryptography](https://github.com/pyca/cryptography) from 42.0.5 to 43.0.1.
    - [Changelog](https://github.com/pyca/cryptography/blob/main/CHANGELOG.rst)
    - [Commits](https://github.com/pyca/cryptography/compare/42.0.5...43.0.1)
    - dependency-name: cryptography
    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
2024-11-12 Bump zipp from 3.17.0 to 3.19.1 in /Heatstroke/heatstroke_warning_system
    Bumps [zipp](https://github.com/jaraco/zipp) from 3.17.0 to 3.19.1.
    - [Release notes](https://github.com/jaraco/zipp/releases)
    - [Changelog](https://github.com/jaraco/zipp/blob/main/NEWS.rst)
    - [Commits](https://github.com/jaraco/zipp/compare/v3.17.0...v3.19.1)
    - dependency-name: zipp
    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
2024-11-12 Bump djangorestframework in /Heatstroke/heatstroke_warning_system
    Bumps [djangorestframework](https://github.com/encode/django-rest-framework) from 3.15.1 to 3.15.2.
    - [Release notes](https://github.com/encode/django-rest-framework/releases)
    - [Commits](https://github.com/encode/django-rest-framework/compare/3.15.1...3.15.2)
    - dependency-name: djangorestframework
    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
2024-11-21 Bump pillow in /Heatstroke/heatstroke_warning_system
    Bumps [pillow](https://github.com/python-pillow/Pillow) from 10.2.0 to 10.3.0.
    - [Release notes](https://github.com/python-pillow/Pillow/releases)
    - [Changelog](https://github.com/python-pillow/Pillow/blob/main/CHANGES.rst)
    - [Commits](https://github.com/python-pillow/Pillow/compare/10.2.0...10.3.0)
    - dependency-name: pillow
    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
2024-12-04 Bump urllib3 in /Heatstroke/heatstroke_warning_system
    Bumps [urllib3](https://github.com/urllib3/urllib3) from 2.2.1 to 2.2.2.
    - [Release notes](https://github.com/urllib3/urllib3/releases)
    - [Changelog](https://github.com/urllib3/urllib3/blob/main/CHANGES.rst)
    - [Commits](https://github.com/urllib3/urllib3/compare/2.2.1...2.2.2)
    - dependency-name: urllib3
    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
2024-12-07 Bump django in /Heatstroke/heatstroke_warning_system
    Bumps [django](https://github.com/django/django) from 4.2.16 to 4.2.17.
    - [Commits](https://github.com/django/django/compare/4.2.16...4.2.17)
    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
